ImperialCollegeLondon/QTIP/Images/Diagrams/MotorDriverSetupSchematic.png

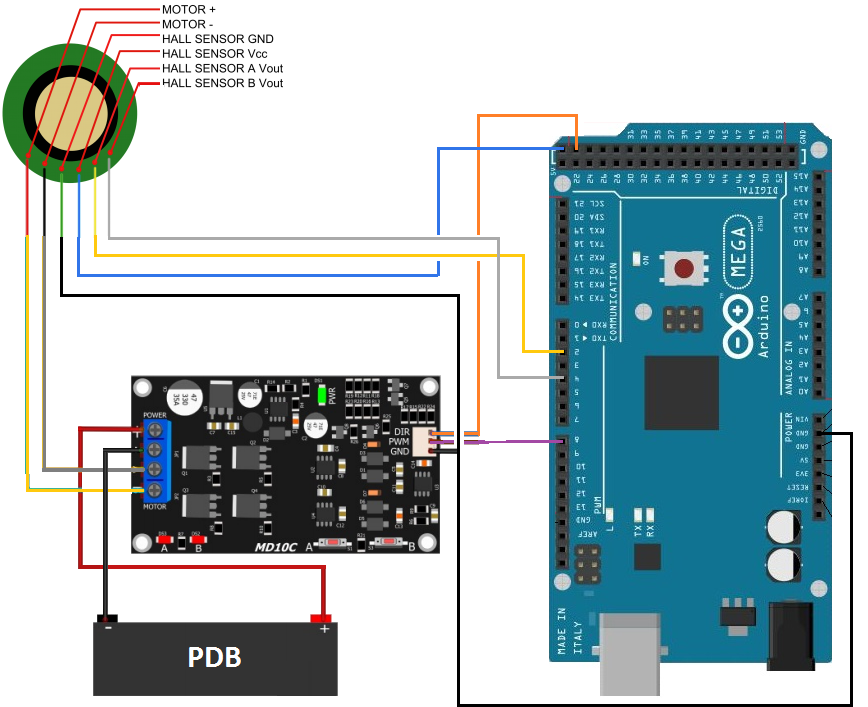
Images/Diagrams/MotorDriverSetupSchematic.png
