ImperialCollegeLondon/QTIP/Report/Figures/real.jpg

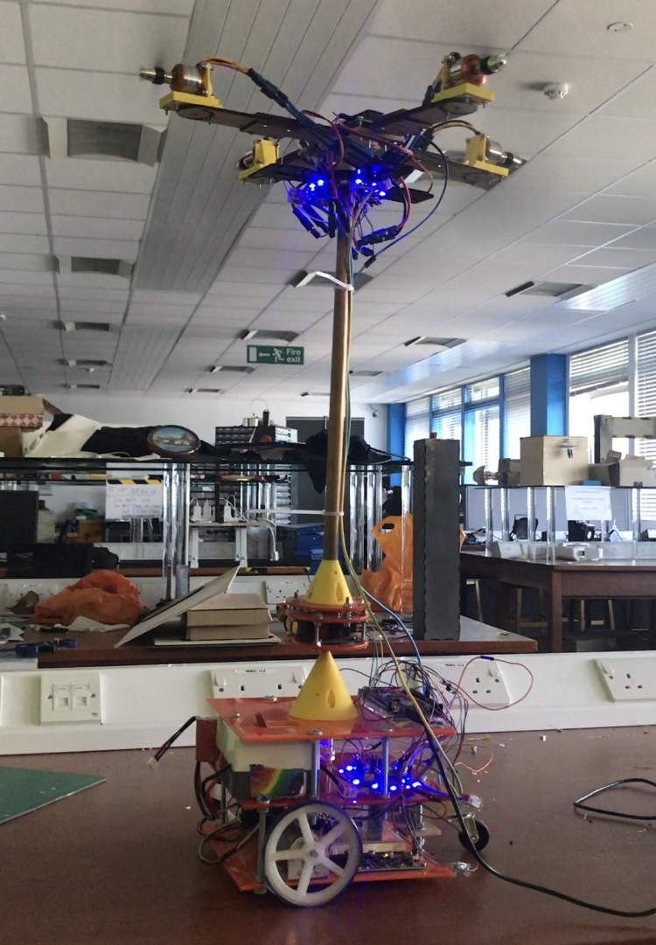
Report/Figures/real.jpg
