ImperialCollegeLondon/QTIP/README.md

# Quadrotor Topped Inverted Pendulum (QTIP)
