ImperialCollegeLondon/QTIP/Ruoxuan Jiang/Math Model (important).docx

1DOF Model:

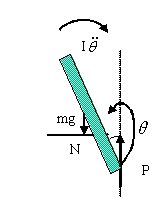
[picture p3: figure]

fθ’

mg

L

l

T2

T1

Torque equilibrium equation:

θ=((T2-T1)L+m_p glsinθ-θfl)/J

u=T1-T1

Setting , when ,,.

ϕ=(uL-m_p glϕ-ϕfl)/J

Linear Model:

[ϕϕ]=[0, 1(-m_p gl)/J, -(fl)/J][ϕϕ]+[0L/J]u

2DOF Model:

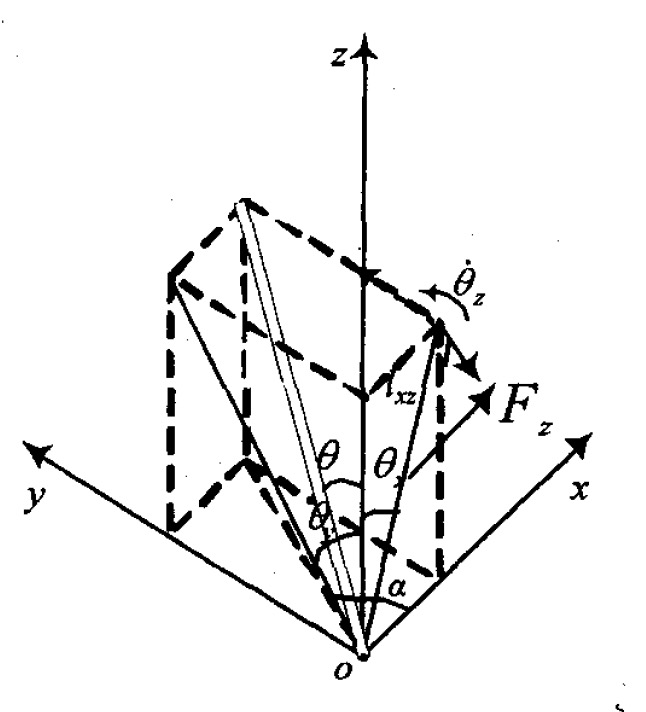
[picture p4: figure]

T2

T1

T4

fθx’

fθy’

mg

T3

By Lagrange's Equations:

L=T-V

d/(dt)((∂L)/(∂θ_x))-(∂L)/(∂θ_x)=F

T=1/2m_p gl^2 θ_x ^2

V=m_p glcosθ_x

L=T-V=1/2m_p l^2 θ_x ^2 -m_p glcosθ_x

d/(dt)((∂L)/(∂θ_x))-(∂L)/(∂θ_x)=m_p l^2 θ_x -m_p glsinθ_x

u1=T2-T1

m_p l^2 θ_x -m_p glsinθ_x =u1-θ_x f

Setting, when,,.

Setting θ_x =θ+π , when θ≪1 , cosθ_x =-1, sinθ_x =-θ .

θ=(-m_p glθ+u1-θf)/(m_p l^2)

Linear Model of system 1:

[θθ]=[0, 1-g/l, -f/(m_p l^2)][θθ]+[01/(m_p l^2)]u1

By symmetry:

Setting θ_y =ϕ+π , when ϕ≪1 , cosθ_y =-1, sinθ_y =-ϕ .

u2=T4-T3

ϕ=(-m_p glϕ+u2-ϕf)/(m_p l^2)

Linear Model of system 2:

[ϕϕ]=[0, 1-g/l, -f/(m_p l^2)][ϕϕ]+[01/(m_p l^2)]u2

3DOF Model:

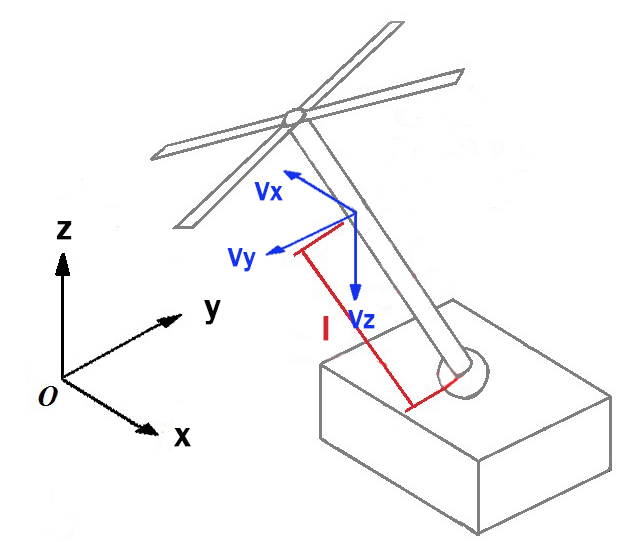
[picture p5: figure]

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
Setting the coordinate system of the pendulum around the point of O, which origin is the pivot connecting the pendulum and cart, is P=[x, y, z] .

z=√(l^2 -x^2 -y^2)

By Lagrange's Equations:

L=T-V

d/(dt)((∂L)/(∂θ_x))-(∂L)/(∂θ_x)=F

T=Tk+Tr

, which Tk is the kinetic energy, and Tr is the rotational energy.

Tr=1/2J_p Ω^T Ω

Ω=(P×P)/(L^2)=[yz-zyzx-xzxy-yx]/l^2

Tr=1/2J_p

Tk=1/2m_p v_p^2

v_p =√(v_x ^2 +v_y ^2 +v_z ^2)=√(x^2 +y^2 +z^2)

V=m_p gz

L=T-V=1/2m_p (x^2 +y^2 +z^2 )+1/2J_p Ω^T Ω-m_p gz

d/(dt)((∂L)/(∂x))-(∂L)/(∂x)=Tx

d/(dt)((∂L)/(∂y))-(∂L)/(∂y)=Ty

d/(dt)((∂L)/(∂ψ))-(∂L)/(∂ψ)=ft

u1=T2-T1-xf

u2=T4-T3-yf

Position Model:

R_x (ϕ)=[1, 0, 00, cos⁡(ϕ), sin⁡(ϕ)0, -sin⁡(ϕ), cos⁡(ϕ)]

R_y (θ)=[cos⁡(θ), 0, -sin⁡(θ)0, 1, 0sin⁡(θ), 0, cos⁡(θ)]

R_z (ψ)=[cos⁡(ψ), sin⁡(ψ), 0-sin⁡(ψ), cos⁡(ψ), 00, 0, 1]

The composite rotation matrix R depends on the order in which the roll, pitch and yaw rotations are applied as follows:

R_(zyx) =(R_x (ϕ)R_y (θ)R_z (ψ))^T

=[cos(ψ)cos(θ), -sin(ψ)cos(ϕ)+cos(ψ)sin(θ)sin(ϕ), sin(ψ)sin(ϕ)+cos(ψ)sin(θ)cos(ϕ)sin(ψ)cos(θ), cos(ψ)cos(ϕ)+sin(ψ)sin(θ)sin(ϕ), -cos(ψ)sin(ϕ)+sin(ψ)sin(θ)cos(ϕ)-sin(θ), cos(θ)sin(ϕ), cos(θ)cos(ϕ)]

[TxTyTz]=R_(zyx) [u1u20]=[u1cos(ψ)cos(θ)-u2sin(ψ)cos(ϕ)-sin(ϕ)sin(θ)cos(ψ)u2cos(ϕ)cos(ψ)+sin(ϕ)sin(ψ)sin(θ)+u1sin(ψ)cos(θ)u2sin(ϕ)cos(θ)-u1sin(θ)]

External moment vectors on each axis of the coordinate system:

∑ M=Iω+ω(Iω)

Angular velocity around each axis:

ω=[p, q, r]

Rotating inertia of three axis of this system:

I=diag[I_x , I_y , I_z ]

Setting as the

∑ M=[τ_p τ_q τ_r ]=[Lu1Lu2dFt]=[Lk_p (ω_2^2 -ω_1^2 )-xfLk_p (ω_4^2 -ω_3^2 )-yfdFt]

[pqr]=[(I_y -I_z)/(I_x)qr-Lk_p (ω_2^2 -ω_1^2 )-xf(I_y -I_x)/(I_y)pr-Lk_p (ω_4^2 -ω_3^2 )-yf(I_x -I_y)/(I_z)pq+dFt]

The relationship between Euler angular velocity and ω be expressed as:

[pqr]=[1, t, 00, cos⁡(ϕ), sin⁡(ϕ)0, -sin⁡(ϕ), cos⁡(ϕ)][pqr]

Table of Parameters:

Symbol | Definition | Symbol | Definition
ϕ | angle (rad) between pendulum and y axis upward | θ | angle (rad) between pendulum and y axis downward
D | Disturbance from the cart | m_p | Mass of pendulum
T_1 | Trust force from the right propeller | T_2 | Trust force from the left propeller
s | direction of the rotation | l | Distance from the origin to the mass center of the pendulum
g | Gravity | f | Friction disturbance (such as air)
J | Moment of inertial of the pendulum | L | length of the pendulum
l_i | Radius of propeller | C_D | Drag coefficient of propeller
C_(DF) | Zero lift drag | C_L | Lift coefficient of propeller
AR | Aspect Ratio | SE | Span efficiency factor
ω_i | Velocity of one propeller | F_D | Drag force of propeller
f_m | Resistance of propeller motor | K_V | Propeller motor back emf constant
K_Q | Propeller motor torque constant
V_(quad) | Voltage of propeller velocity | u_i | Command of Propeller
u_(max) | Max propeller command | d | Distance from the top center to the propeller center
ω | Angular velocity of pendulum about each axis | I | Rotating inertia of three axis of the system
