ImperialCollegeLondon/QTIP/Charlie Bell MSc/Presentation 10th July 18.pptx

## Quadrotor Top Inverted Pendulum (Q-TIP)

Controller design and synthesis

## Q-TIP: Purpose

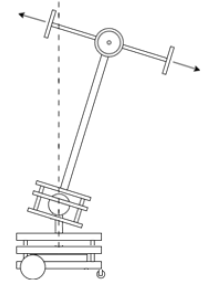
[picture p22: figure]

To showcase the capabilities of H_(∞) control on a highly nonlinear system.
Possibility of academic use for undergraduate students.
Demonstrate the importance of robust controllers in real systems.
The model is currently being verified using Simscape.

## H-infinity loop-shaping

Advantages:
Easily applicable to MIMO systems.
Similarly to LQR, the control problem is formulated as an optimisation problem.
Can be designed for the nominal model and applied to the real model.
Loop-shaping weights the plant transfer function in the frequency domain to minimise the sensitivity to noise, disturbances and plant-model mismatch.
Disadvantages:
Need a reasonably good model for the system to be controlled.
Controller is only optimal in relation to the selected cost function.

## H-infinity loop-shaping

Good tracking

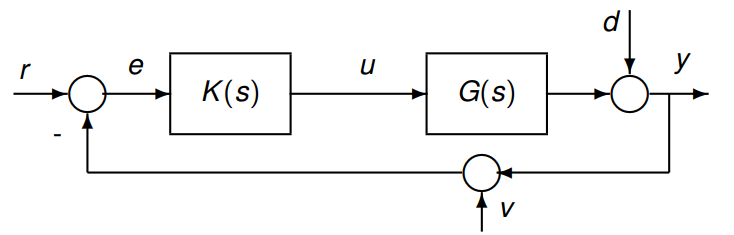
[picture p23: figure]

Noise attenuation,
Under multiplicative uncertainty

Robust under additive uncertainty

## MATLAB Robust Control Toolbox

augment/AUGW
hinfsyn

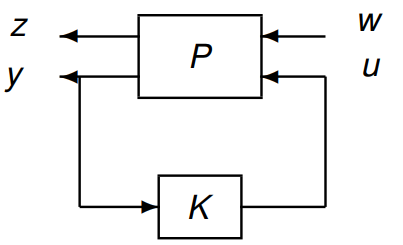
[picture p24: figure]
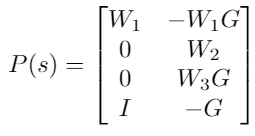
[picture p25: figure]

## Simulink Simscape Multibody

A powerful tool for simulating and visualising electromechanical systems.
Uses a reference frames and bodies along with physical bodies to build a model.
Can be linearised and extracted using linmod.

## Next steps and problems to be solved

- Testing of parts and subsystems.
- Estimation of parameters.
- Motor modelling.
- Measuring the buggy yaw
