ImperialCollegeLondon/QTIP/Ruoxuan Jiang/1DOF/1DOF model.docx

f

D

T3

T1

Torque equilibrium equation:

θ=((T3-T1)L+m_p gsinθ-θfl)/J

Setting , when ,,.

ϕ=(uL-m_p gϕ-ϕfl)/J

The mass of the pendulum: 0.853kg

The radius of the rod: 1.2cm, 0.012m

Then length of the pendulum: 0.52m

The density of the rod: 6939 kg/m^3

The mass of the rod: 0.095kg, length = 0.4m

m(rod)=(0.006^2 -0.005^2 )×π×0.36×6939=0.0863kg

m(small)=(0.006^2 -0.005^2 )×π×0.032×6939=0.00767kg

m(cone)=0.0184+0.00767=0.02607kg

m(cylinder)=0.1731kg

m(top)=0.853-0.095-0.02607-0.1731=0.5588kg

m(board)=(m(top))/2=0.2794kg

https://c-motion.com/v3dwiki/index.php/Segment_Inertia

Moment if inertia (cone):

x=r/R=0.015/0.038=0.3947

σ=1+x+x^2 =1+0.3947+0.3947^2 =1.5505

CG(cone)=((1+2x+3x^2 )h)/(4σ)=0.0138m

d(cone)=0.0138+0.04=0.0538m

δ=(3*m(cone))/(h*(r^2 +R*r+R^2 )π)=(3*0.02607)/(0.038*(0.015^2 +0.015*0.038+0.038^2 )*π)=297.78

a1=9/(20π), a2=((1+x+x^2 +x^3 +x^4 ))/σ=1.6363

b1=3/80, b2=((1+4x+10x^2 +4x^3 +x^4 ))/(σ^2)=1.8331

J(cone)=(a1*a2*m(cone)^2)/(δh)+b1b2m(cone)h^2 =1.4327e-05+2.5878e-06=0.000162kg*m^2

Moment if inertia (cylinder):

J(cylinder)=1/12m(cylinder)(3*r^2 +h^2 )=1/12*0.1731*(3*0.085^2 +0.04^2 )=0.000336kg*m^2

d(cone)=0.02m

Moment if inertia (rod):

J(rod)=1/12m(rod)(3*(r^2 +R^2 )+h^2 )=1/12*0.095*(3*(0.005^2 +0.006^2 )+0.4^2 )=0.0037kg*m^2

d(rod)=0.2+0.04+0.038=0.278m

Moment if inertia (top):

J_w (top)=1/12m(board)(d^2 +h^2 )=1/12*0.2794*(0.45^2 +??^2 )=0.0047kg*m^2

J_d (top)=1/12m(board)(w^2 +h^2 )=1/12*0.2794*(??^2 +0.003^2 )

J(top)=J_w (top)+J_d (top)

d(cone)=L-h=??m

Moment if inertia (pendulum):

J_p =∑ J+md^2 =J(cone)+J(cylinder)+J(rod)+J(top)+m(cone)d(cone)^2 +m(cylinder)d(cylinder)^2 + m(rod)d(crod)^2 +m(top)d(top)^2 =

Force of Propeller:

https://m-selig.ae.illinois.edu/props/propDB.html

Drag Force:

F_D =1/2ρv_(air) ^2 C_D S

Velocity of Propeller:

ω_i (rad/s)=(-1/(f_m K_V K_Q)+√(1/(f_m ^2 K_V ^2 K_Q ^2)-4F_d ((i_f)/(K_Q)-(V_(quad) u_i)/(f_m K_V u_(max)))))/(2F_d)

ω_i (rpm)=(ω_i ((rad)/s)*60)/(2π)

https://www.micromo.com/technical-library/dc-motor-tutorials/motor-calculations

i_f (Propeller motor friction current)=(P_(elec))/(V_(quad))

f_m (Resistance of propeller motor)=(V_(quad) -(ω_i)/(K_V))/(i_f)=(V_(quad) ^2 -(ω_i V_(quad))/(K_V))/(P_(elec))

https://en.wikipedia.org/wiki/Motor_constants#Motor_velocity_constant,_back_EMF_constant

K_V (Propeller motor speed constant)=(ω_i)/(V_(peak))=K_Q (Propeller motor torque constant)

Total thrust force of one propeller:

T_i =C_T ρω_i (rpm)^2 d_p ^2

Net Force:

u_1 =T_3 -T_1

u_2 =T_4 -T_2

Table of Parameters:

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
