ImperialCollegeLondon/QTIP/Modelling_and_Simulations/Controller designs/motor duty cycle vs servo.xlsx

Servo | Duty | Thrust | *thrust measured after battery was newly charged and at the centre of gravity
580 | 89.1 |  | *measured on rotor 1
590 | 89
600 | 87.5
650 | 85.7
700 | 81.3
750 | 78.1
800 | 75.6
900 | 69.3
1000 | 62.2 | 1.2
1100 | 56.3
1200 | 50 | 2.4
1300 | 43 | 3.2
1400 | 36.7 | 4
1500 | 30.7 | 4.8
1600 | 24.7 | 6
1700 | 17.6 | 6.4
1800 | 11.3 | 7.2
1900 | 5 | 7.6
2000 | 0 | 8.4
