ImperialCollegeLondon/QTIP/Fusion 360/Charlie  - September 2018/F/_distance sensing base Drawing.167a2c57-f452-4fe1-b7c8-098f2b4f054e.png

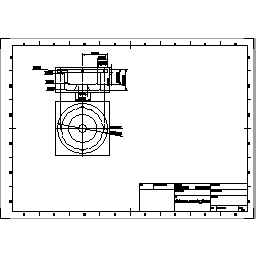
Fusion 360/Charlie - September 2018/F/_distance sensing base Drawing.167a2c57-f452-4fe1-b7c8-098f2b4f054e.png
