ImperialCollegeLondon/QTIP/Fusion 360/Charlie  - September 2018/F/_IR_Sensor_Base Drawing.a6438f55-29fa-4da2-a62e-f884ee1b2ce9.png

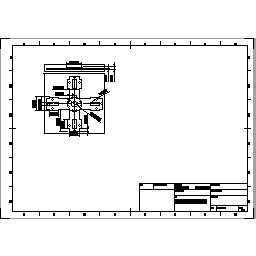
Fusion 360/Charlie - September 2018/F/_IR_Sensor_Base Drawing.a6438f55-29fa-4da2-a62e-f884ee1b2ce9.png
