ImperialCollegeLondon/QTIP/Fusion 360/Charlie  - September 2018/F/_motor_tips Drawing.4671a8ba-175e-485d-b543-e82fb5eeca1d.png

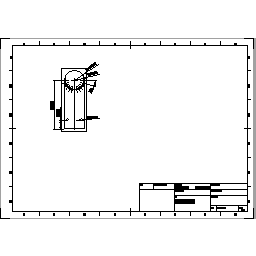
Fusion 360/Charlie - September 2018/F/_motor_tips Drawing.4671a8ba-175e-485d-b543-e82fb5eeca1d.png
