ImperialCollegeLondon/QTIP/Fusion 360/Charlie  - September 2018/F/_MPU6050_base Drawing.3a57cc98-4135-4280-b787-98bc39614aa1.png

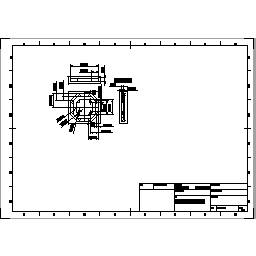
Fusion 360/Charlie - September 2018/F/_MPU6050_base Drawing.3a57cc98-4135-4280-b787-98bc39614aa1.png
