ImperialCollegeLondon/QTIP/Fusion 360/Charlie  - September 2018/F/_platesensor Drawing.8d1b1e26-c095-4f52-aa41-e85070347f9d.png

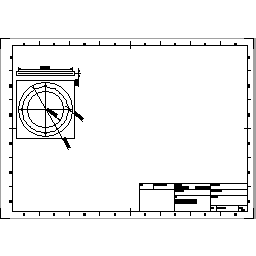
Fusion 360/Charlie - September 2018/F/_platesensor Drawing.8d1b1e26-c095-4f52-aa41-e85070347f9d.png
