ImperialCollegeLondon/QTIP/Images/Diagrams/App.png

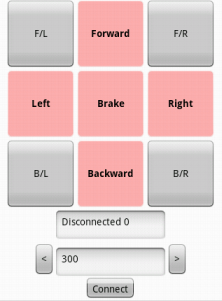
Images/Diagrams/App.png
