ImperialCollegeLondon/QTIP/Images/Diagrams/Directions.png

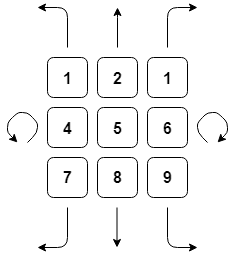
Images/Diagrams/Directions.png
