ImperialCollegeLondon/QTIP/Images/Diagrams/ESCSchem.png

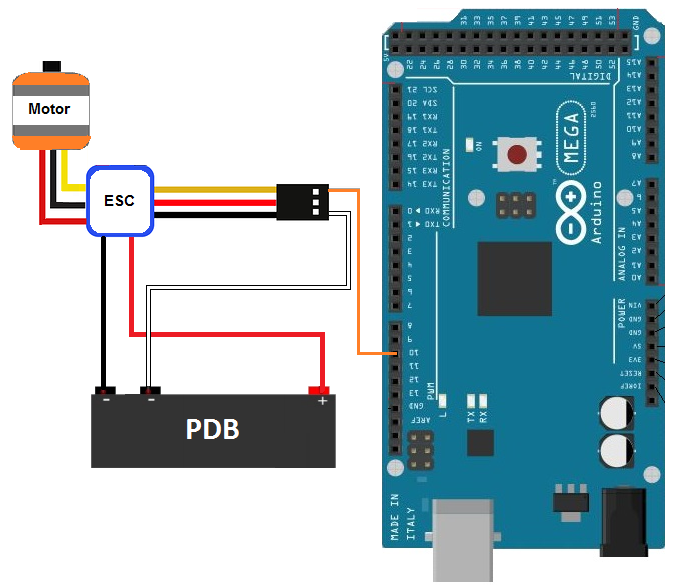
Images/Diagrams/ESCSchem.png
