ImperialCollegeLondon/QTIP/Images/Diagrams/FBD.png

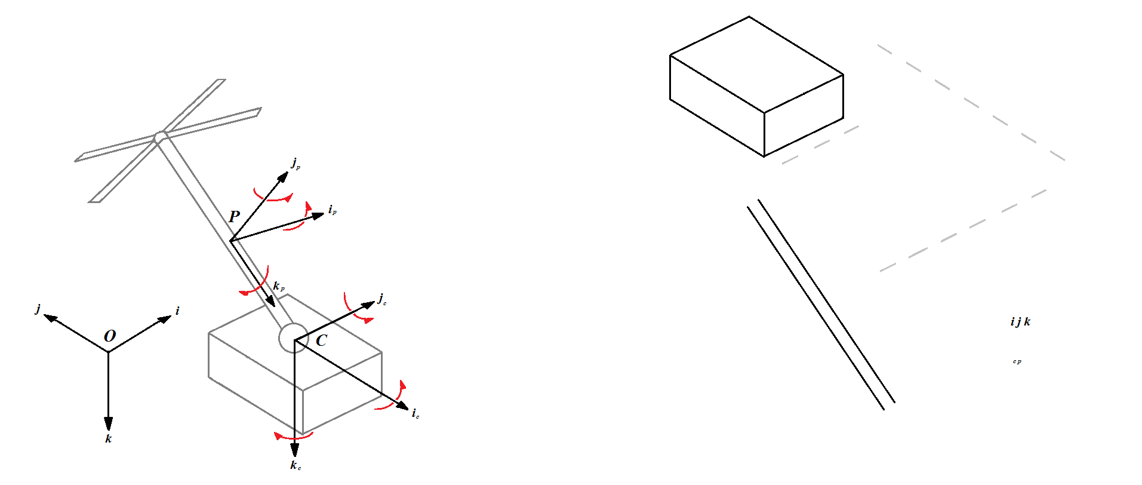
Images/Diagrams/FBD.png
