ImperialCollegeLondon/QTIP/Images/Diagrams/FBDNew.png

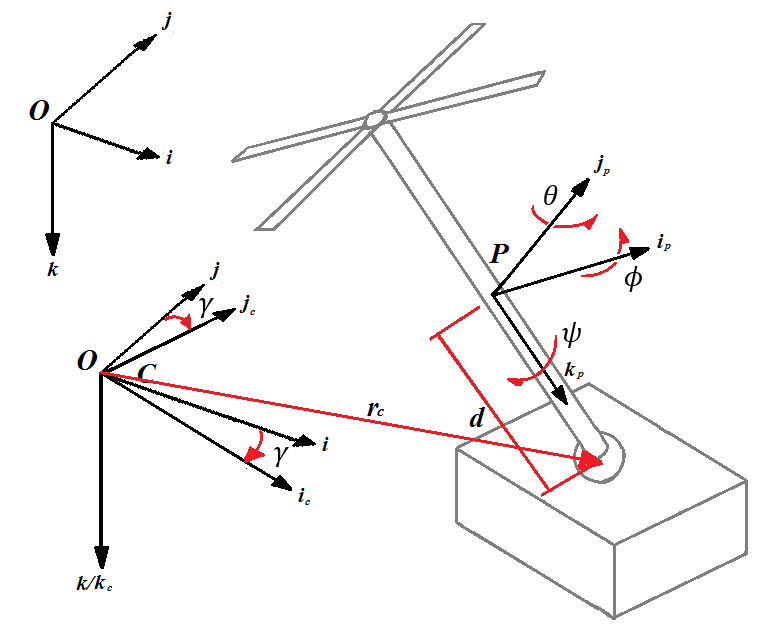
Images/Diagrams/FBDNew.png
