ImperialCollegeLondon/QTIP/Images/Diagrams/FrankiesSkinnyArms.png

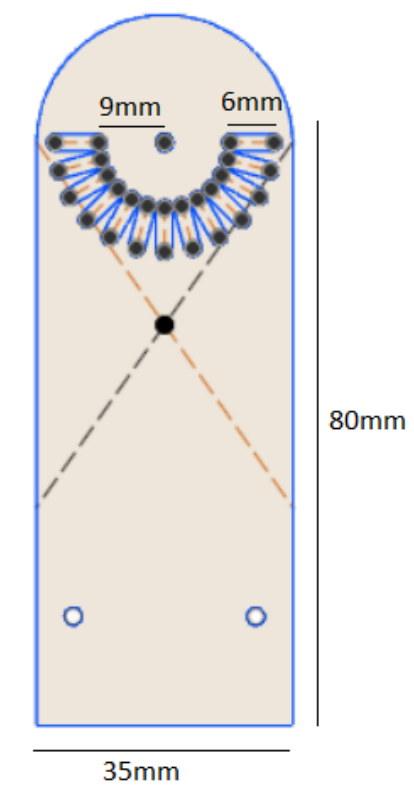
Images/Diagrams/FrankiesSkinnyArms.png
