ImperialCollegeLondon/QTIP/Images/Diagrams/HC05Scheme.png

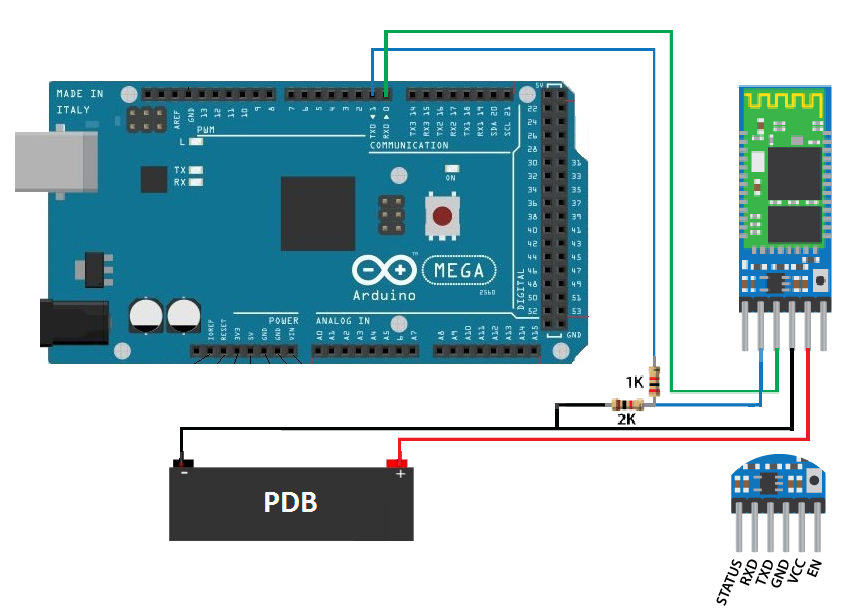
Images/Diagrams/HC05Scheme.png
