ImperialCollegeLondon/QTIP/Images/Diagrams/IRDistanceScheme.png

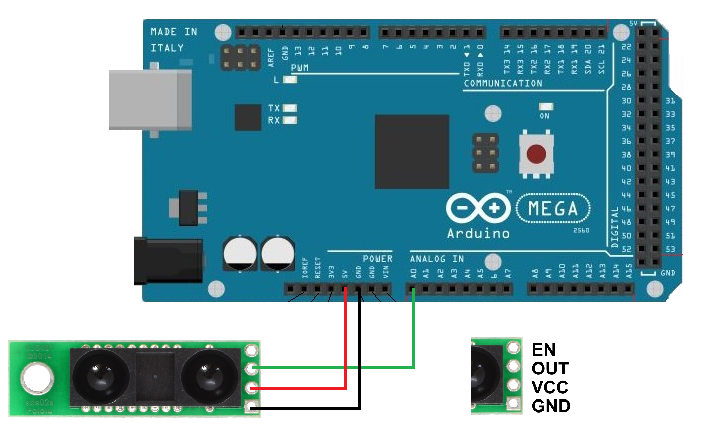
Images/Diagrams/IRDistanceScheme.png
