ImperialCollegeLondon/QTIP/Images/Diagrams/Mega2560.png

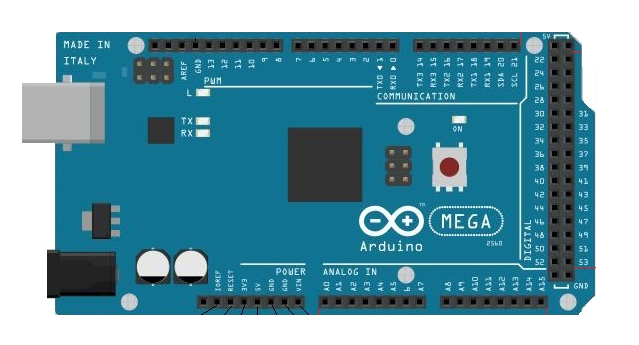
Images/Diagrams/Mega2560.png
