ImperialCollegeLondon/QTIP/Images/Diagrams/MPU6050Schem.png

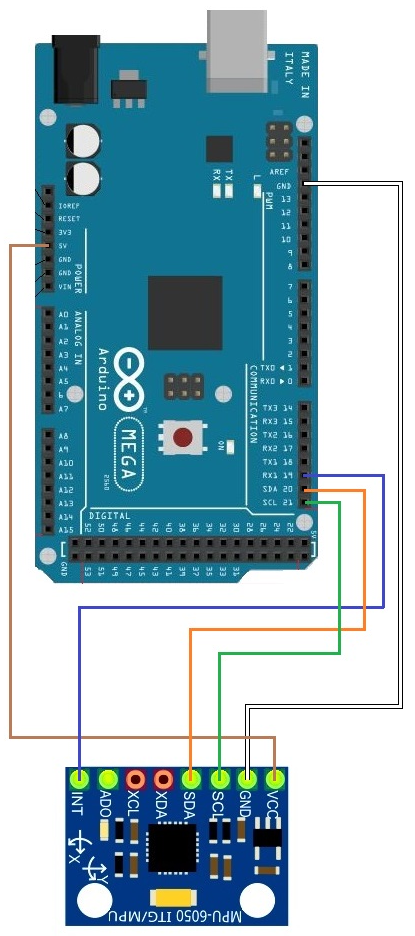
Images/Diagrams/MPU6050Schem.png
