ImperialCollegeLondon/QTIP/Images/Diagrams/QuadrotorFBD.png

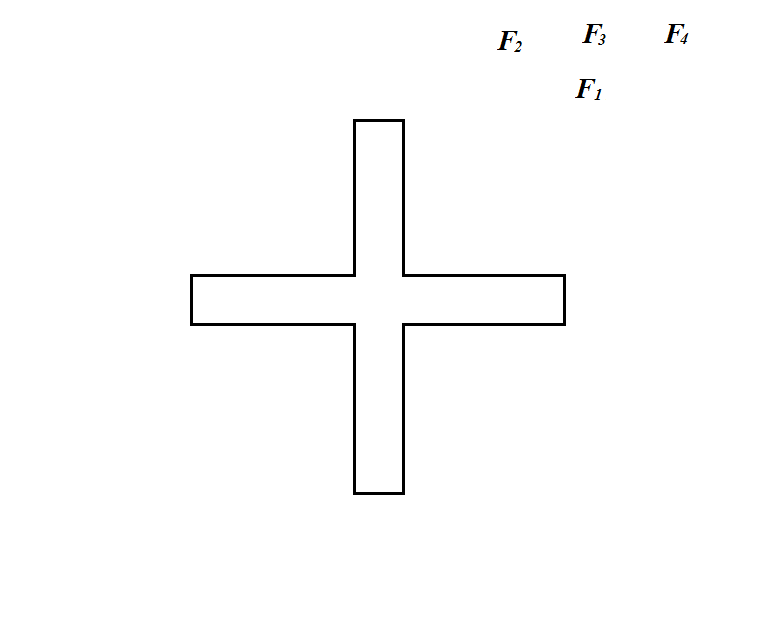
Images/Diagrams/QuadrotorFBD.png
