ImperialCollegeLondon/QTIP/Images/Diagrams/SoftwareDiagram.png

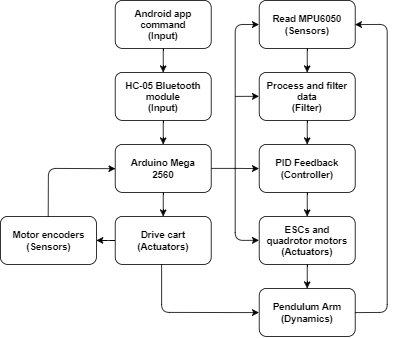
Images/Diagrams/SoftwareDiagram.png
