ImperialCollegeLondon/QTIP/Images/MCU mount/mount_brd.png

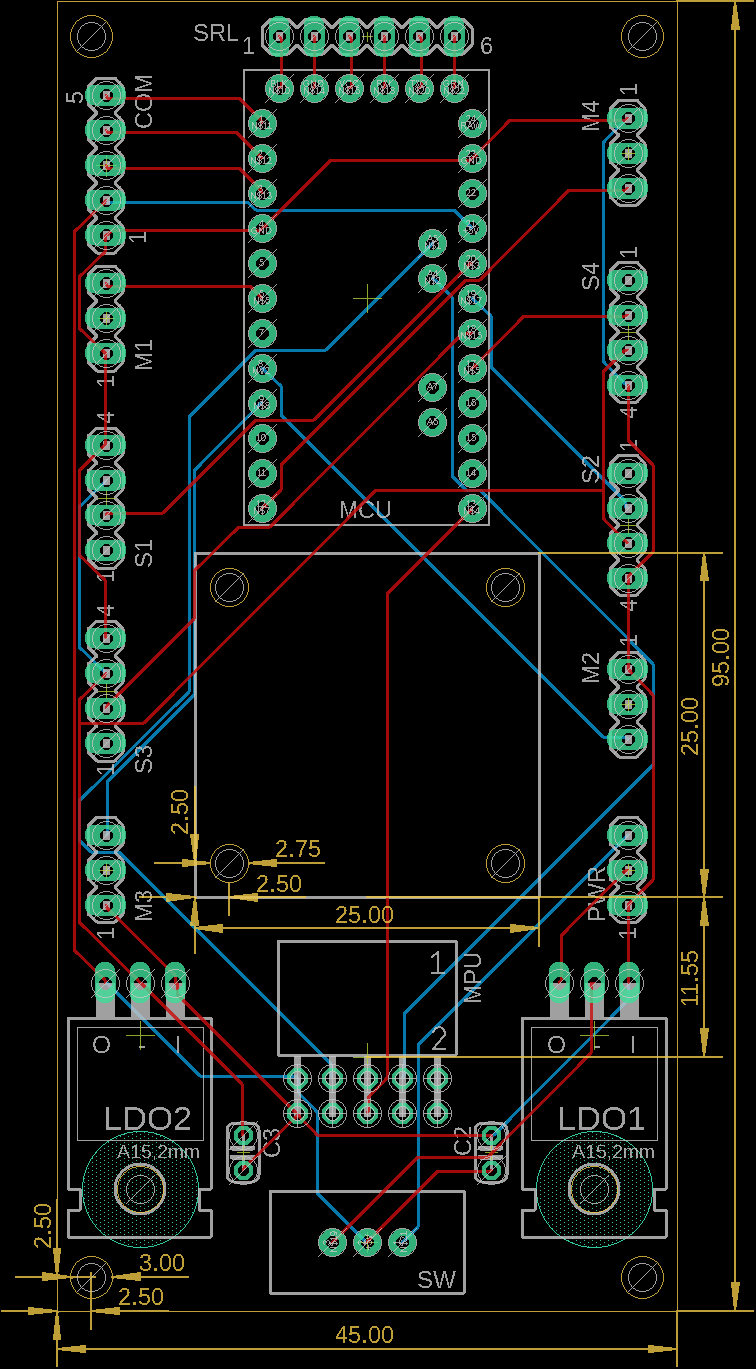
Images/MCU mount/mount_brd.png
