ImperialCollegeLondon/QTIP/Images/MCU mount/mount_sch.png

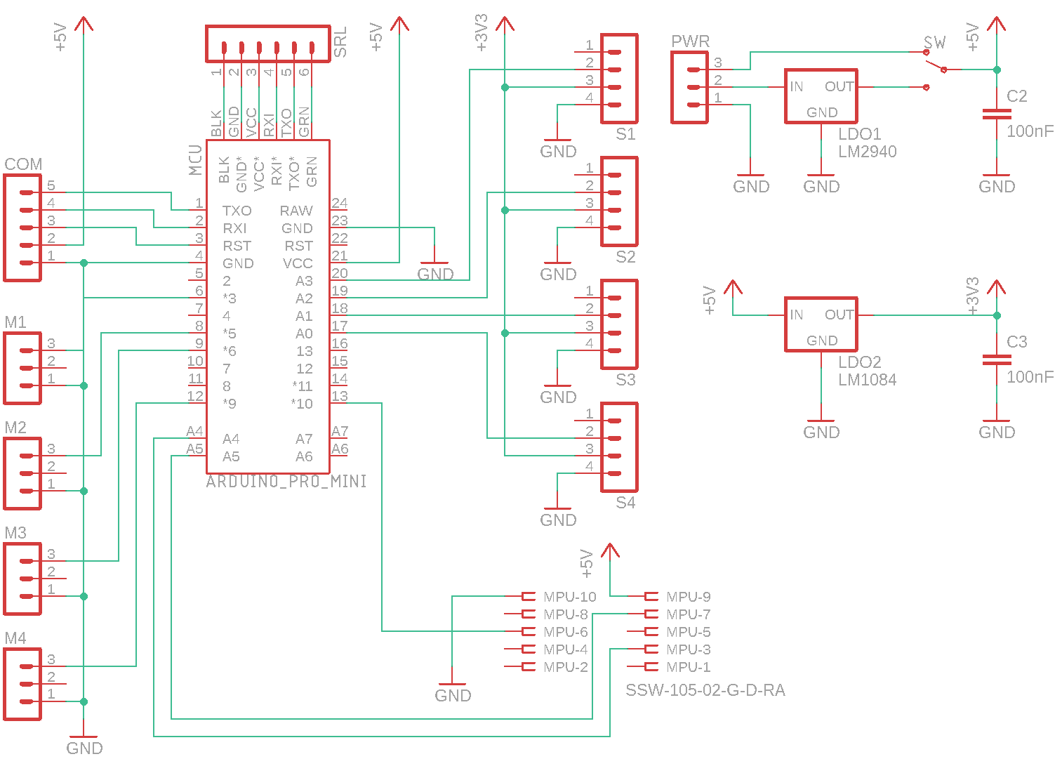
Images/MCU mount/mount_sch.png
