ImperialCollegeLondon/QTIP/Images/Photos/42234530_729942750677188_5877479439666774016_n.jpg

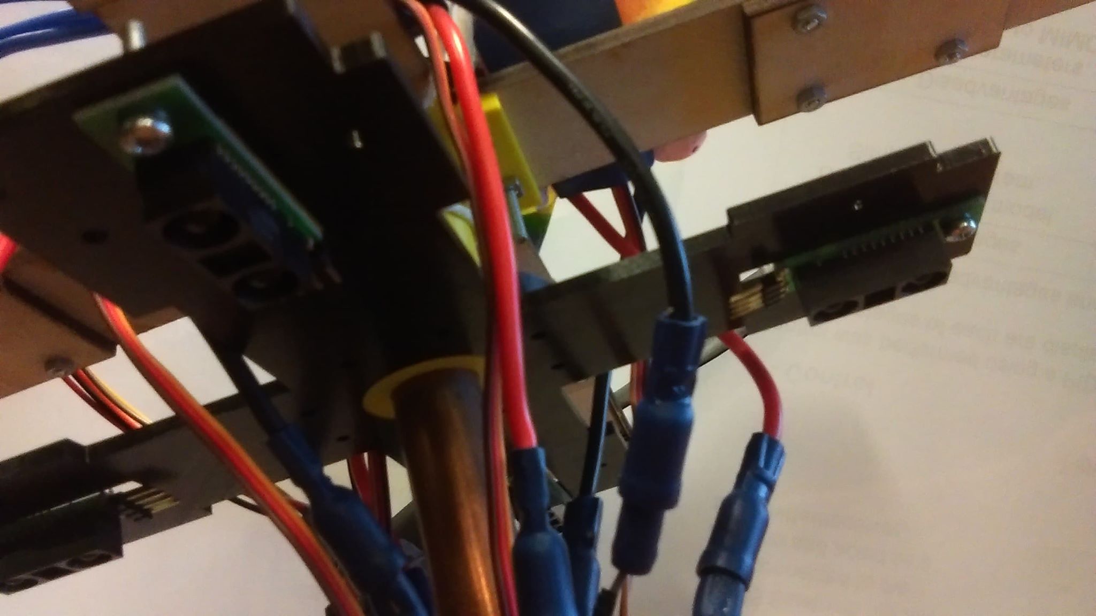
Images/Photos/42234530_729942750677188_5877479439666774016_n.jpg
