ImperialCollegeLondon/QTIP/Images/Photos/CartPhoto.png

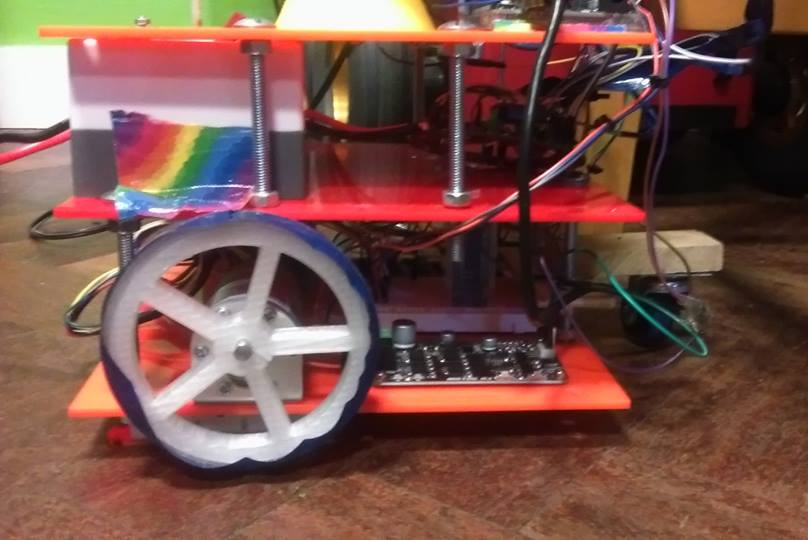
Images/Photos/CartPhoto.png
