ImperialCollegeLondon/QTIP/Images/Photos/CartSwitchPhoto.png

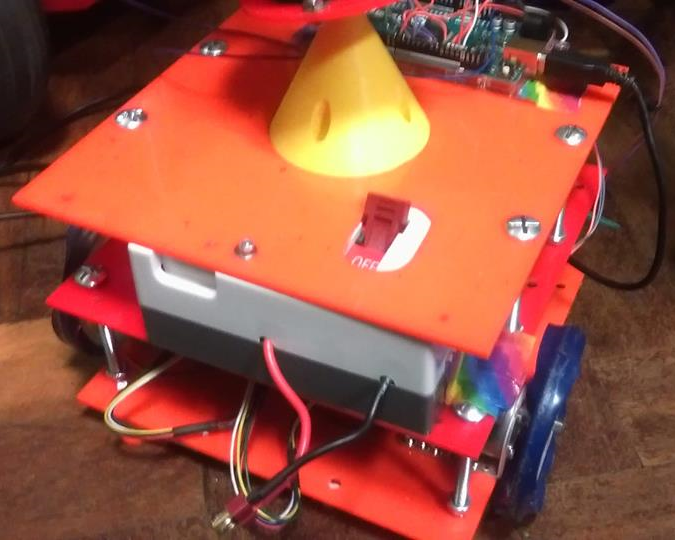
Images/Photos/CartSwitchPhoto.png
