ImperialCollegeLondon/QTIP/Images/Photos/CastorWheel.png

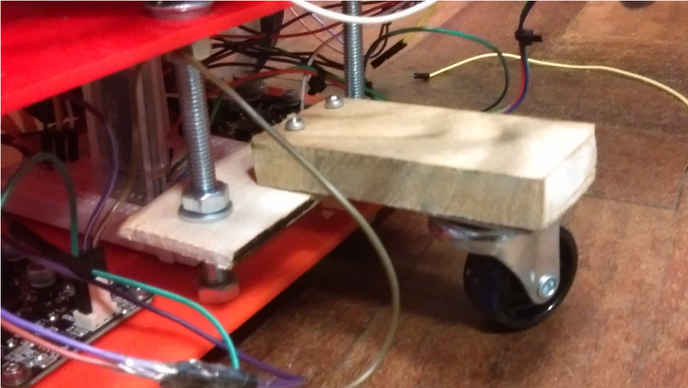
Images/Photos/CastorWheel.png
