ImperialCollegeLondon/QTIP/Images/Photos/Overview.png

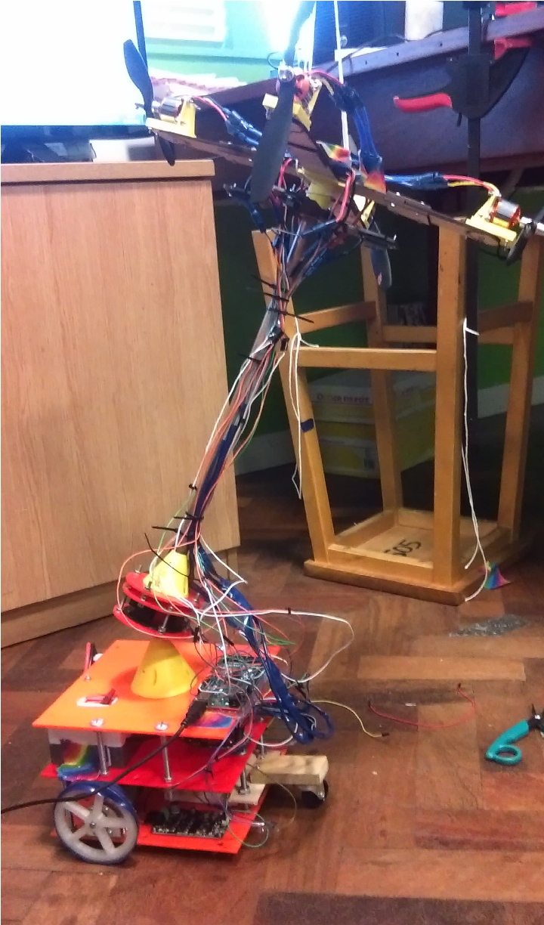
Images/Photos/Overview.png
