ImperialCollegeLondon/QTIP/Images/Photos/QuadrotorArmPhoto.png

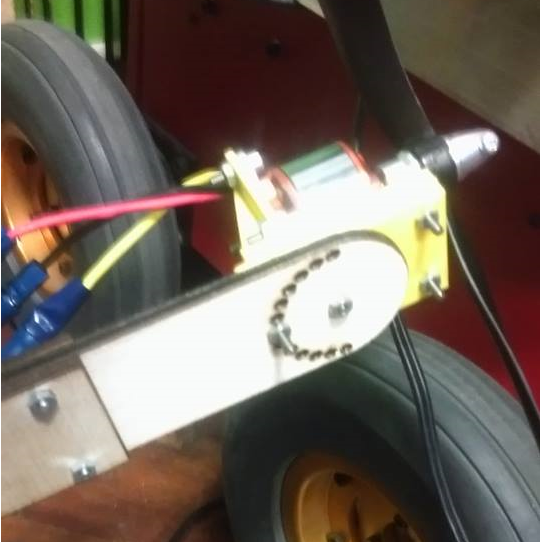
Images/Photos/QuadrotorArmPhoto.png
