ImperialCollegeLondon/QTIP/Images/Photos/QuadrotorPhoto.png

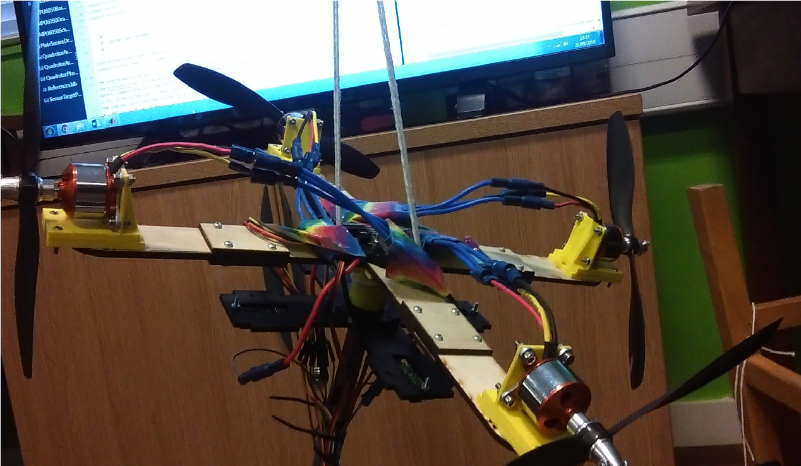
Images/Photos/QuadrotorPhoto.png
