ImperialCollegeLondon/QTIP/Images/Photos/SensorTargetPlatePhoto.png

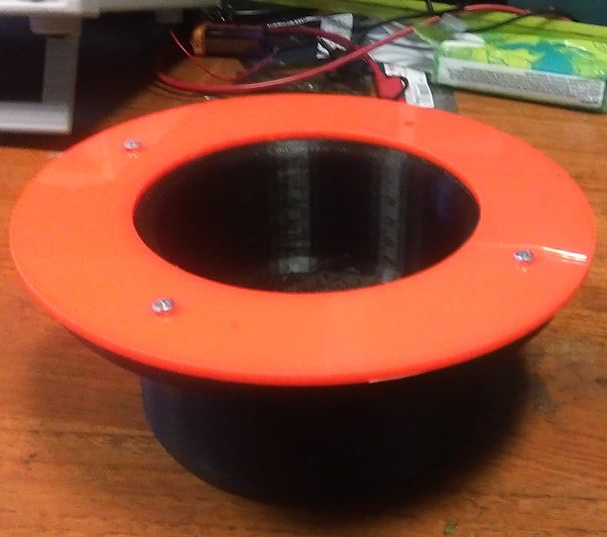
Images/Photos/SensorTargetPlatePhoto.png
