ImperialCollegeLondon/QTIP/Report/Figures/1dof1.jpg

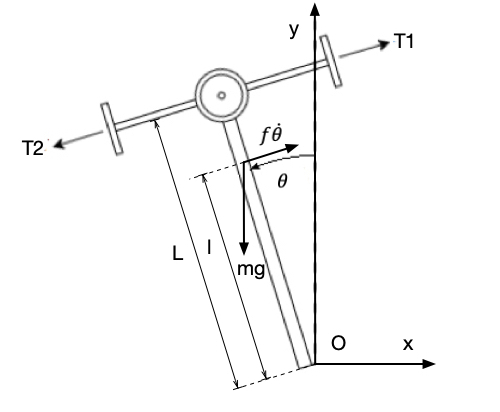
Report/Figures/1dof1.jpg
