ImperialCollegeLondon/QTIP/Report/Figures/1dof.graffle/image1.jpg

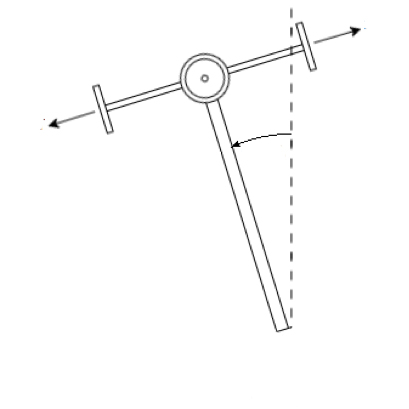
Report/Figures/1dof.graffle/image1.jpg
