ImperialCollegeLondon/QTIP/Report/Figures/2dof1.jpg

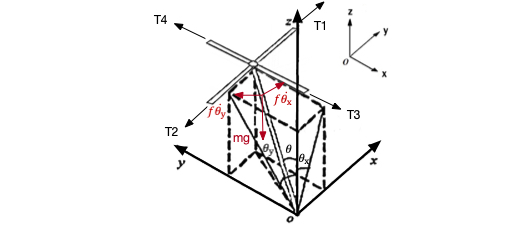
Report/Figures/2dof1.jpg
