ImperialCollegeLondon/QTIP/Report/Figures/2dof2.jpg

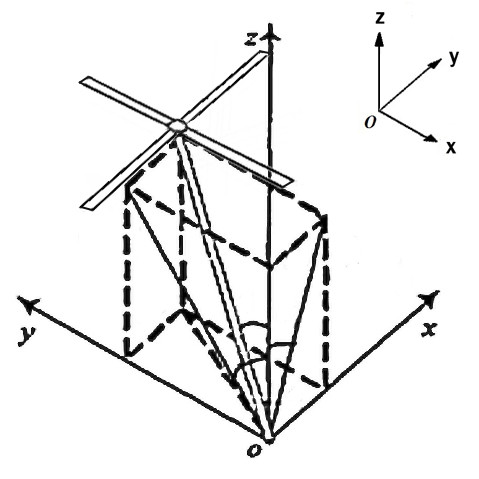
Report/Figures/2dof2.jpg
