ImperialCollegeLondon/QTIP/Report/Figures/2dof3.jpg

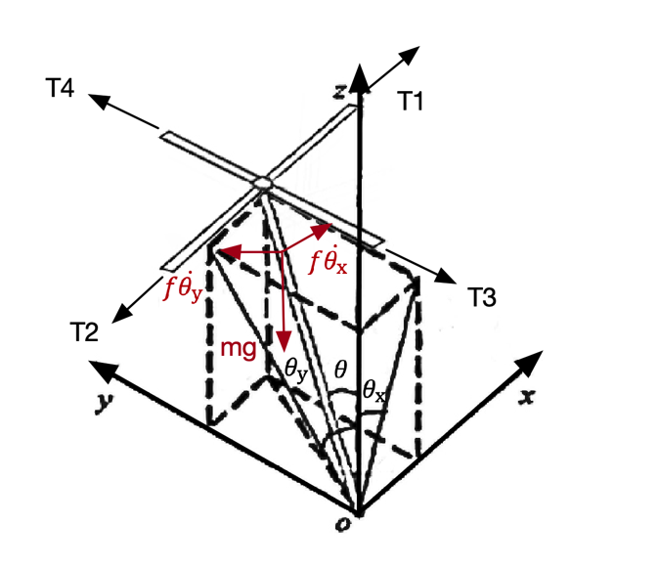
Report/Figures/2dof3.jpg
