ImperialCollegeLondon/QTIP/Report/Figures/3dof1.jpg

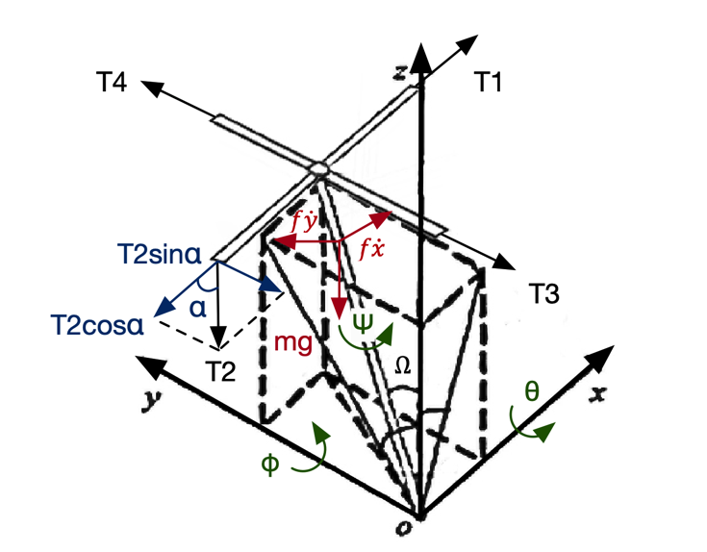
Report/Figures/3dof1.jpg
