ImperialCollegeLondon/QTIP/Report/Figures/3dof.jpg

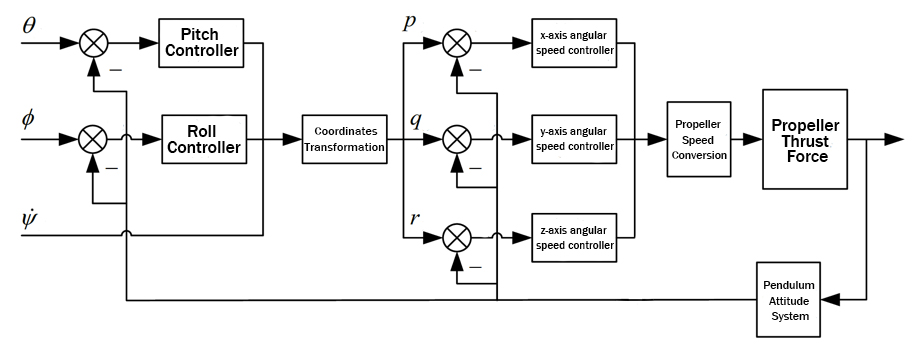
Report/Figures/3dof.jpg
