ImperialCollegeLondon/QTIP/Report/Figures/cone.jpg

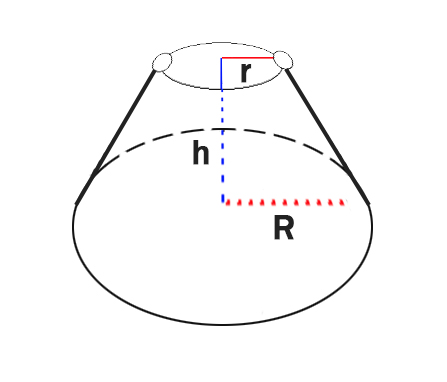
Report/Figures/cone.jpg
