ImperialCollegeLondon/QTIP/Report/Figures/pid_1dof_linear_u.png

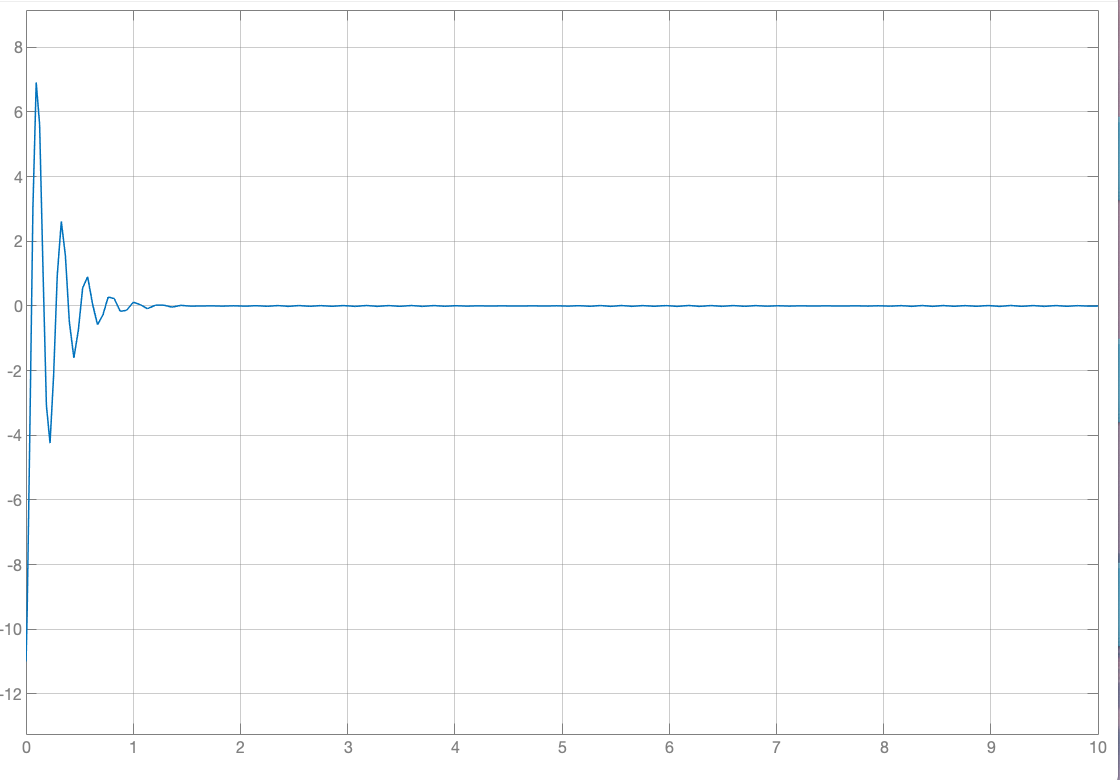
Report/Figures/pid_1dof_linear_u.png
