ImperialCollegeLondon/QTIP/Report/Figures/pid_1dof_nonlinear_u.png

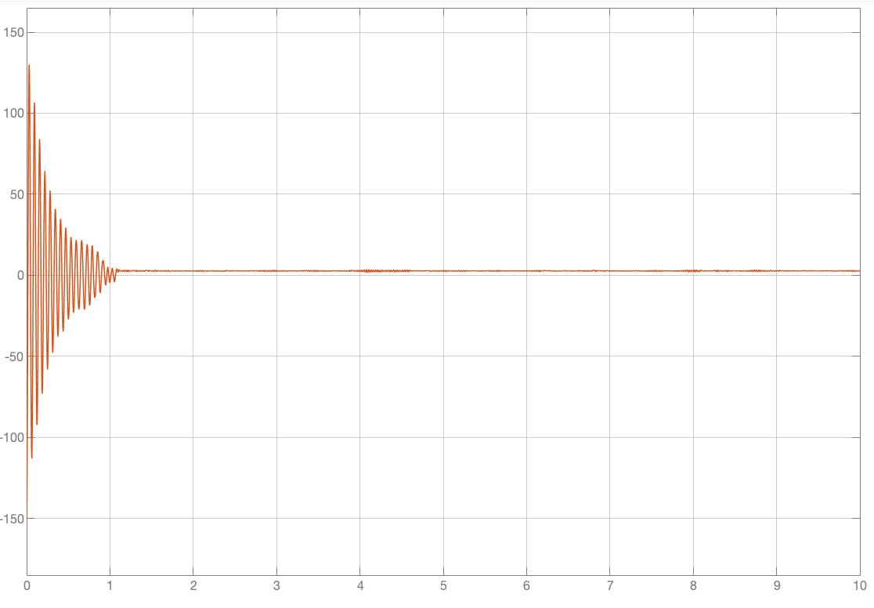
Report/Figures/pid_1dof_nonlinear_u.png
