ImperialCollegeLondon/QTIP/Report/Figures/quadrotor.jpg

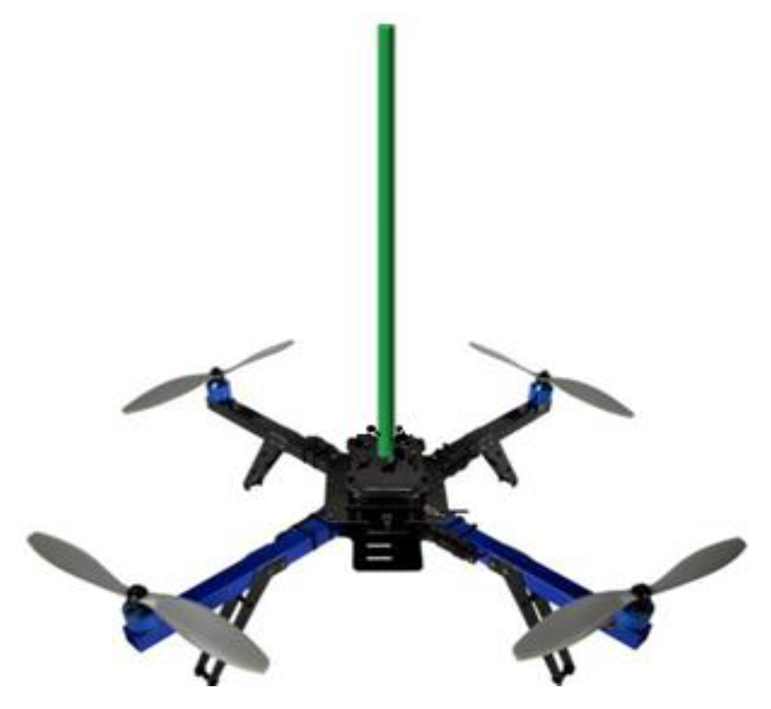
Report/Figures/quadrotor.jpg
