ImperialCollegeLondon/QTIP/Report/Figures/Snip20190828_3.png

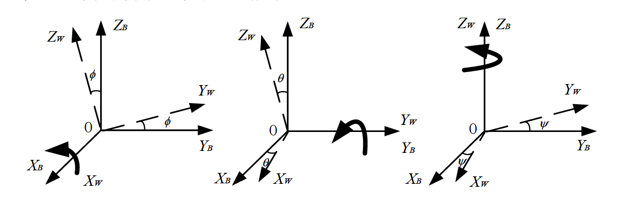
Report/Figures/Snip20190828_3.png
