ImperialCollegeLondon/QTIP/Report/Figures/Snip20190831_1.png

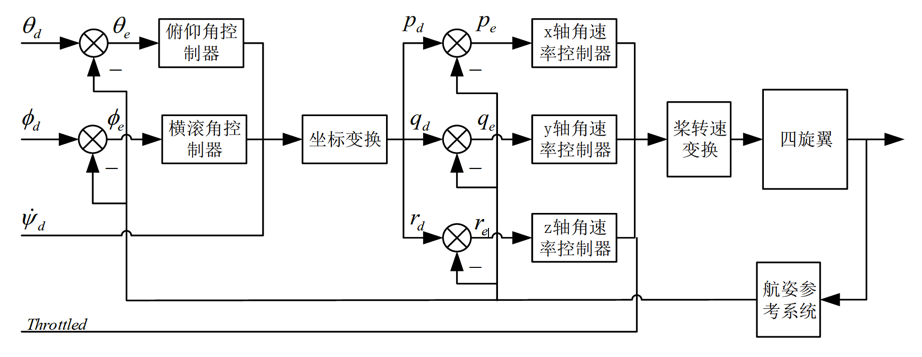
Report/Figures/Snip20190831_1.png
