ImperialCollegeLondon/QTIP/Report/Figures/stru2.graffle/image1.jpg

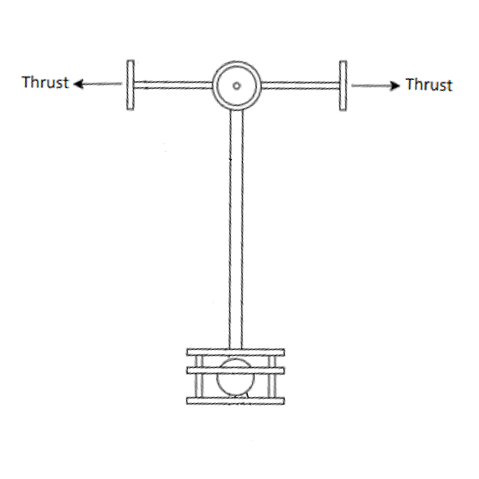
Report/Figures/stru2.graffle/image1.jpg
