ImperialCollegeLondon/QTIP/Report/Figures/stru2.jpg

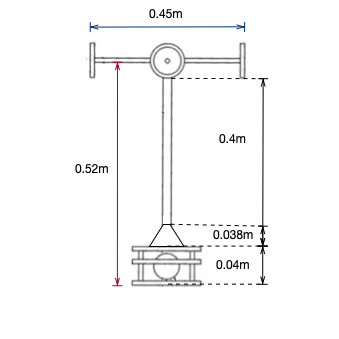
Report/Figures/stru2.jpg
