ImperialCollegeLondon/QTIP/Report/Figures/stru.jpg

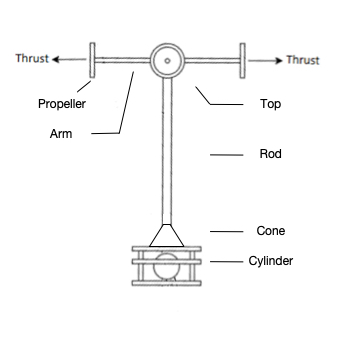
Report/Figures/stru.jpg
