ImperialCollegeLondon/QTIP/Report/Figures/thrust1.png

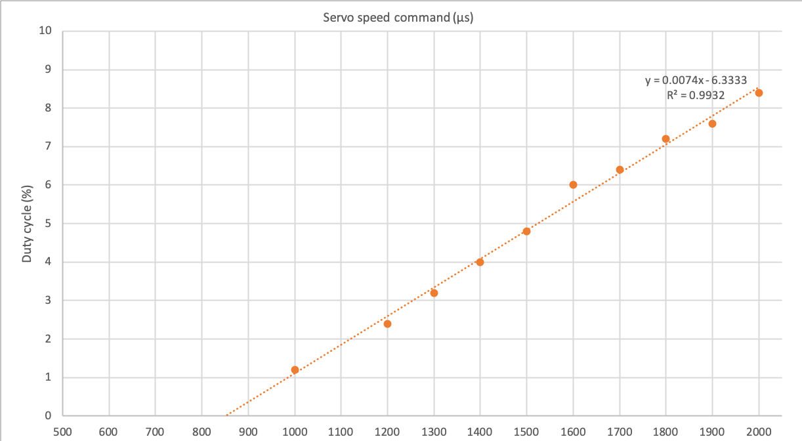
Report/Figures/thrust1.png
