ImperialCollegeLondon/QTIP/Report/Figures/WX20190827-165826@2x.png

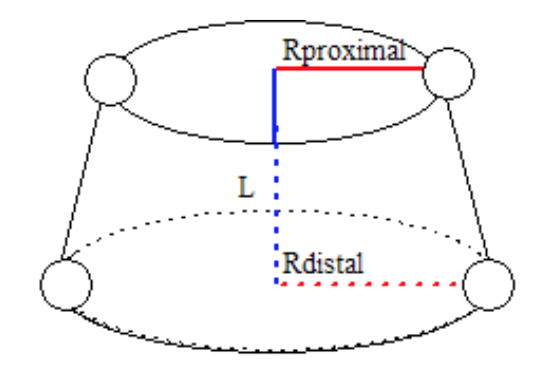
Report/Figures/WX20190827-165826@2x.png
