ImperialCollegeLondon/QTIP/(list of files, cad)

Other CAD files:
Fusion 360/Charlie - September 2018/D/38e7b07e-975d-44f5-a386-fe88bf291c5e.f2d
Fusion 360/Charlie - September 2018/D/65a1e838-8545-4bc1-8616-6649744bad84.f2d
Fusion 360/Charlie - September 2018/D/86ccd2f9-dcbd-4ddc-8e51-228e1d89fba8.f2d
Fusion 360/Charlie - September 2018/D/90396298-6234-49ed-ab1d-8a921f07f61a.f2d
Fusion 360/Charlie - September 2018/D/9a99e573-6a53-4ff8-bab7-74f84905e94e.f2d
Fusion 360/Charlie - September 2018/D/_0 dof.16f6d7bc-6823-48f0-af0c-f57e1ecf2a03.f3d
Fusion 360/Charlie - September 2018/D/_3dof ball joint limit.0818d55c-cfe8-4e3d-abe9-b31afa20470b.f3d
Fusion 360/Charlie - September 2018/D/_Bot_Buggy.67e68b21-76c9-4f74-ae45-ccdb9ae60464.f3d
Fusion 360/Charlie - September 2018/D/_FYP_Project.30689574-17b8-4f28-82bc-4a6d63cc6bb8.f3d
Fusion 360/Charlie - September 2018/D/_FYP_Project.e5b741b6-de03-4121-ac4c-455f43841e72.f3d
Fusion 360/Charlie - September 2018/D/_Mid_Buggy v1.d3fb6025-7d80-4e23-9cef-7aad12eae831.f3d
Fusion 360/Charlie - September 2018/D/_Top Motor Base.8a076834-c428-4551-9572-302d4211c724.f3d
Fusion 360/Charlie - September 2018/D/_Top_Buggy.84060d08-1e92-4c1e-bf3c-88f7ae413858.f3d
Fusion 360/Charlie - September 2018/D/_Wheel.690aa9d6-0443-4a5d-b359-7cdf34e08d0b.f3d
Fusion 360/Charlie - September 2018/D/_base_mount.aa962479-57d6-4ac7-87ad-e300ce6e1ebd.f3d
Fusion 360/Charlie - September 2018/D/_base_pendulum.549c1694-39ab-46a9-882e-bae70d5cbc87.f3d
Fusion 360/Charlie - September 2018/D/_bot bug 3d.2a260a3c-bb4b-4e1b-82d3-91d949180a34.f3d
Fusion 360/Charlie - September 2018/D/_bot_3D Joint.e1579b06-012f-4a59-916d-8962dbeb67df.f3d
Fusion 360/Charlie - September 2018/D/_bot_joint_plat.a9002315-c0e8-42a7-860a-0e363f9e170a.f3d
Fusion 360/Charlie - September 2018/D/_bot_joint_print.fe6107df-6920-4303-81a5-f8ed9eccbd60.f3d
Fusion 360/Charlie - September 2018/D/_camara top.273ecf29-dca3-4243-8d60-dc86f891365d.f3d
Fusion 360/Charlie - September 2018/D/_camaraside.b155b807-4a76-4751-a1d2-1a41744d9572.f3d
Fusion 360/Charlie - September 2018/D/_distance sensing base.b2dd820b-1519-46c9-ab9c-6e6810837444.f3d
Fusion 360/Charlie - September 2018/D/_double hinge.c73257d0-b62e-4581-b0a2-3ff71a05638e.f3d
Fusion 360/Charlie - September 2018/D/_full ball joint.4e98c3ed-7798-4968-9d94-7e01fe91851c.f3d
Fusion 360/Charlie - September 2018/D/_full structure.1b13a275-2b40-48d6-b8e3-0c061137abb3.f3d
Fusion 360/Charlie - September 2018/D/_joint_plat.13a4afc8-236e-41c7-890d-325f51f290e3.f3d
Fusion 360/Charlie - September 2018/D/_magnetic side.8d1368b1-dcc9-4457-ae46-fbf8c22e0692.f3d
Fusion 360/Charlie - September 2018/D/_motor base dimensions.a5abcd56-95d1-46e5-bf08-5968f5c64851.f3d
Fusion 360/Charlie - September 2018/D/_motor_base.ad4c3909-f81e-402d-8d75-62db66e27172.f3d
Fusion 360/Charlie - September 2018/D/_motor_tip_hold.2b4d487d-3483-482a-b781-73941d4ea9ba.f3d
Fusion 360/Charlie - September 2018/D/_motor_tip_hold_3D.4e5e734c-ea4f-4d34-8a0c-042d3958b99a.f3d
Fusion 360/Charlie - September 2018/D/_motor_tips_3D.b541b689-42d2-46c7-8ee2-95b9a4902e00.f3d
Fusion 360/Charlie - September 2018/D/_pend_connector.6113d6a6-ff1e-4e22-9ab8-4d74f2541897.f3d
Fusion 360/Charlie - September 2018/D/_pendulum.cdab3254-af17-42fb-b564-d7b699957a59.f3d
Fusion 360/Charlie - September 2018/D/_pendulum_3D.12d040be-d2c6-4b73-b759-7a2067bdbaf2.f3d
Fusion 360/Charlie - September 2018/D/_platesensor.ecb4e9c5-dacc-4da2-a371-615c9f19e751.f3d
Fusion 360/Charlie - September 2018/D/_rod_connector.48ad1f99-6f84-489f-a4ef-45fa8a27765f.f3d
Fusion 360/Charlie - September 2018/D/_sphere.aaea48cb-db7c-48fc-b7af-8c36bddd8de9.f3d
Fusion 360/Charlie - September 2018/D/_top joint with sphere and pin.c2aade80-2db6-4851-90f9-92e80436383d.f3d
Fusion 360/Charlie - September 2018/D/_top_3D Joint.6bec6398-35c7-4d56-b3d9-7a9582a43d99.f3d
Fusion 360/Charlie - September 2018/D/_top_3D Joint.c7dbc639-92e2-42d0-a810-be37d3c962a2.f3d
Fusion 360/Charlie - September 2018/D/_top_joint_plat.c9467187-65b0-4059-81ec-43d11235db25.f3d
Fusion 360/Charlie - September 2018/D/_top_joint_print.99a3b0ba-869c-4ecd-9347-2f76327057b6.f3d
Fusion 360/Charlie - September 2018/D/_yaw_control.2c9c1f70-ecd5-4a5c-8550-4e08fa1fc980.f3d
Fusion 360/Charlie - September 2018/D/_yawlimit.5599f793-35cf-4079-a206-6b33523ced57.f3d
Fusion 360/Charlie - September 2018/D/f1c0c4da-e56a-4784-b9db-c6fed15633ae.f2d
Fusion 360/Charlie - September 2018/F/_0 dof.16f6d7bc-6823-48f0-af0c-f57e1ecf2a03.f3d
Fusion 360/Charlie - September 2018/F/_3dof ball joint limit.0818d55c-cfe8-4e3d-abe9-b31afa20470b.f3d
Fusion 360/Charlie - September 2018/F/_Bot_Buggy.67e68b21-76c9-4f74-ae45-ccdb9ae60464.f3d
Fusion 360/Charlie - September 2018/F/_FYP_Project.30689574-17b8-4f28-82bc-4a6d63cc6bb8.f3d
Fusion 360/Charlie - September 2018/F/_FYP_Project.e5b741b6-de03-4121-ac4c-455f43841e72.f3d
Fusion 360/Charlie - September 2018/F/_IR_Sensor_Base Drawing.a6438f55-29fa-4da2-a62e-f884ee1b2ce9.f2d
Fusion 360/Charlie - September 2018/F/_MPU6050_base Drawing.3a57cc98-4135-4280-b787-98bc39614aa1.f2d
Fusion 360/Charlie - September 2018/F/_Mid_Buggy v1.d3fb6025-7d80-4e23-9cef-7aad12eae831.f3d
Fusion 360/Charlie - September 2018/F/_Top Motor Base.8a076834-c428-4551-9572-302d4211c724.f3d
Fusion 360/Charlie - September 2018/F/_Top_Buggy.84060d08-1e92-4c1e-bf3c-88f7ae413858.f3d
Fusion 360/Charlie - September 2018/F/_Wheel.690aa9d6-0443-4a5d-b359-7cdf34e08d0b.f3d
Fusion 360/Charlie - September 2018/F/_base_mount.aa962479-57d6-4ac7-87ad-e300ce6e1ebd.f3d
Fusion 360/Charlie - September 2018/F/_base_pendulum.549c1694-39ab-46a9-882e-bae70d5cbc87.f3d
Fusion 360/Charlie - September 2018/F/_bot bug 3d.2a260a3c-bb4b-4e1b-82d3-91d949180a34.f3d
Fusion 360/Charlie - September 2018/F/_bot_3D Joint.e1579b06-012f-4a59-916d-8962dbeb67df.f3d
Fusion 360/Charlie - September 2018/F/_bot_joint_plat.a9002315-c0e8-42a7-860a-0e363f9e170a.f3d
Fusion 360/Charlie - September 2018/F/_bot_joint_print.fe6107df-6920-4303-81a5-f8ed9eccbd60.f3d
Fusion 360/Charlie - September 2018/F/_camara top.273ecf29-dca3-4243-8d60-dc86f891365d.f3d
Fusion 360/Charlie - September 2018/F/_camaraside.b155b807-4a76-4751-a1d2-1a41744d9572.f3d
Fusion 360/Charlie - September 2018/F/_distance sensing base Drawing.167a2c57-f452-4fe1-b7c8-098f2b4f054e.f2d
Fusion 360/Charlie - September 2018/F/_distance sensing base.b2dd820b-1519-46c9-ab9c-6e6810837444.f3d
Fusion 360/Charlie - September 2018/F/_double hinge.c73257d0-b62e-4581-b0a2-3ff71a05638e.f3d
Fusion 360/Charlie - September 2018/F/_full ball joint.4e98c3ed-7798-4968-9d94-7e01fe91851c.f3d
Fusion 360/Charlie - September 2018/F/_full structure.1b13a275-2b40-48d6-b8e3-0c061137abb3.f3d
Fusion 360/Charlie - September 2018/F/_joint_plat.13a4afc8-236e-41c7-890d-325f51f290e3.f3d
Fusion 360/Charlie - September 2018/F/_magnetic side.8d1368b1-dcc9-4457-ae46-fbf8c22e0692.f3d
Fusion 360/Charlie - September 2018/F/_motor base dimensions.a5abcd56-95d1-46e5-bf08-5968f5c64851.f3d
Fusion 360/Charlie - September 2018/F/_motor_base.ad4c3909-f81e-402d-8d75-62db66e27172.f3d
Fusion 360/Charlie - September 2018/F/_motor_tip_hold.2b4d487d-3483-482a-b781-73941d4ea9ba.f3d
Fusion 360/Charlie - September 2018/F/_motor_tip_hold_3D.4e5e734c-ea4f-4d34-8a0c-042d3958b99a.f3d
Fusion 360/Charlie - September 2018/F/_motor_tips Drawing.4671a8ba-175e-485d-b543-e82fb5eeca1d.f2d
Fusion 360/Charlie - September 2018/F/_motor_tips_3D.b541b689-42d2-46c7-8ee2-95b9a4902e00.f3d
Fusion 360/Charlie - September 2018/F/_pend_connector.6113d6a6-ff1e-4e22-9ab8-4d74f2541897.f3d
Fusion 360/Charlie - September 2018/F/_pendulum.cdab3254-af17-42fb-b564-d7b699957a59.f3d
Fusion 360/Charlie - September 2018/F/_pendulum_3D.12d040be-d2c6-4b73-b759-7a2067bdbaf2.f3d
Fusion 360/Charlie - September 2018/F/_platesensor Drawing.7e41d2c2-2f0d-4407-9537-a03fe6288127.f2d
Fusion 360/Charlie - September 2018/F/_platesensor Drawing.8d1b1e26-c095-4f52-aa41-e85070347f9d.f2d
Fusion 360/Charlie - September 2018/F/_platesensor.ecb4e9c5-dacc-4da2-a371-615c9f19e751.f3d
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
