ImperialCollegeLondon/QTIP/Plot Results/CharlieBellResults.xlsx

Sheet: Sheet2
2 | 0 | 0 | 0 | 2 | 0 | 0 | 0 | 2 | -0.14 | 0.08 | 0.1 | 2 | -0.77 | 0.03 | 0.03 | 2 | 0 | 0 | 0
11 | 0.14 | 0.02 | -0.03 | 5 | 0 | 0 | 0 | 5 | -0.14 | 0.08 | 0.1 | 12 | 0.87 | 0.28 | -0.26 | 4 | 0 | 0 | 0
20 | 0.14 | 0.02 | -0.03 | 14 | 0 | 0.04 | 0.32 | 15 | -0.01 | 0.31 | 0.01 | 16 | 0.87 | 0.28 | -0.26 | 13 | -0.08 | 0.03 | 0
24 | 0.14 | 0.02 | -0.03 | 23 | 0 | 0.04 | 0.32 | 18 | -0.01 | 0.31 | 0.01 | 25 | 0.87 | 0.28 | -0.26 | 24 | -0.08 | 0.03 | 0
33 | 0.14 | 0.02 | -0.03 | 26 | 0 | 0.04 | 0.32 | 28 | -0.01 | 0.31 | 0.01 | 34 | 0.87 | 0.28 | -0.26 | 33 | -0.08 | 0.03 | 0
43 | 0.14 | 0.02 | -0.03 | 36 | 0 | 0.04 | 0.32 | 37 | -0.01 | 0.31 | 0.01 | 43 | 0.87 | 0.28 | -0.26 | 36 | -0.08 | 0.03 | 0
52 | 0.14 | 0.02 | -0.03 | 45 | 0 | 0.04 | 0.32 | 46 | -0.01 | 0.31 | 0.01 | 53 | 0.87 | 0.28 | -0.26 | 45 | -0.08 | 0.03 | 0
61 | 0.14 | 0.02 | -0.03 | 54 | 0 | 0.04 | 0.32 | 56 | -0.01 | 0.31 | 0.01 | 62 | 0.87 | 0.28 | -0.26 | 54 | -0.08 | 0.03 | 0
71 | 0.14 | 0.02 | -0.03 | 64 | 0 | 0.04 | 0.32 | 65 | -0.01 | 0.31 | 0.01 | 66 | 0.87 | 0.28 | -0.26 | 63 | -0.08 | 0.03 | 0
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
