ImperialCollegeLondon/QTIP/Test Data/Loop duration/190517-04.xlsx

10 | mean | 10.01
10 | st.dev | 0.5922642504
9
11
10
10
10 |  |  | logged after 1 second
11
9
10
9
10
11
10
10
10
10
10
10
10
11
9
10
10
9
11
10
10
10
10
10
10
10
11
10
9
10
10
10
10
10
10
11
9
10
10
10
10
10
10
11
10
9
10
11
10
10
9
10
11
9
10
10
11
10
9
10
11
10
10
9
11
10
10
9
10
11
10
10
9
11
10
9
10
11
10
10
9
10
11
10
10
10
10
10
10
9
11
10
10
10
10
10
10
10
9
11
10
10
10
10
10
10
10
11
10
9
10
11
9
10
10
10
11
9
10
10
10
10
10
10
11
10
9
10
11
9
10
10
10
11
9
10
10
11
10
10
9
11
10
9
10
11
10
10
9
10
11
9
10
10
11
10
10
9
11
10
10
9
11
10
10
10
9
11
10
10
10
10
10
10
9
11
10
10
10
11
9
10
10
9
11
10
10
10
10
10
10
10
11
9
10
10
10
10
10
10
10
11
10
9
10
10
10
10
10
11
10
9
10
10
11
10
9
10
11
9
10
10
11
10
9
10
11
10
10
9
10
11
9
10
10
11
10
10
9
11
10
10
10
10
10
10
9
10
11
10
10
9
11
10
9
10
11
10
10
10
9
11
10
10
10
10
10
10
9
11
10
10
10
10
10
10
10
11
10
9
10
10
10
10
10
10
11
9
10
10
10
10
10
10
10
11
9
10
10
11
10
9
10
11
9
10
10
11
10
9
10
10
11
10
10
9
11
9
10
10
11
10
10
9
11
10
10
9
10
11
10
9
10
11
10
10
10
10
10
9
10
11
10
10
10
9
11
10
10
10
10
10
10
9
11
10
10
10
11
9
10
10
10
10
10
10
10
10
10
10
10
11
9
10
10
9
11
10
10
10
11
9
10
10
11
10
9
10
11
9
10
10
10
