ImperialCollegeLondon/QTIP/Images/Diagrams/IR_Sensor_Base Drawing v4.pdf

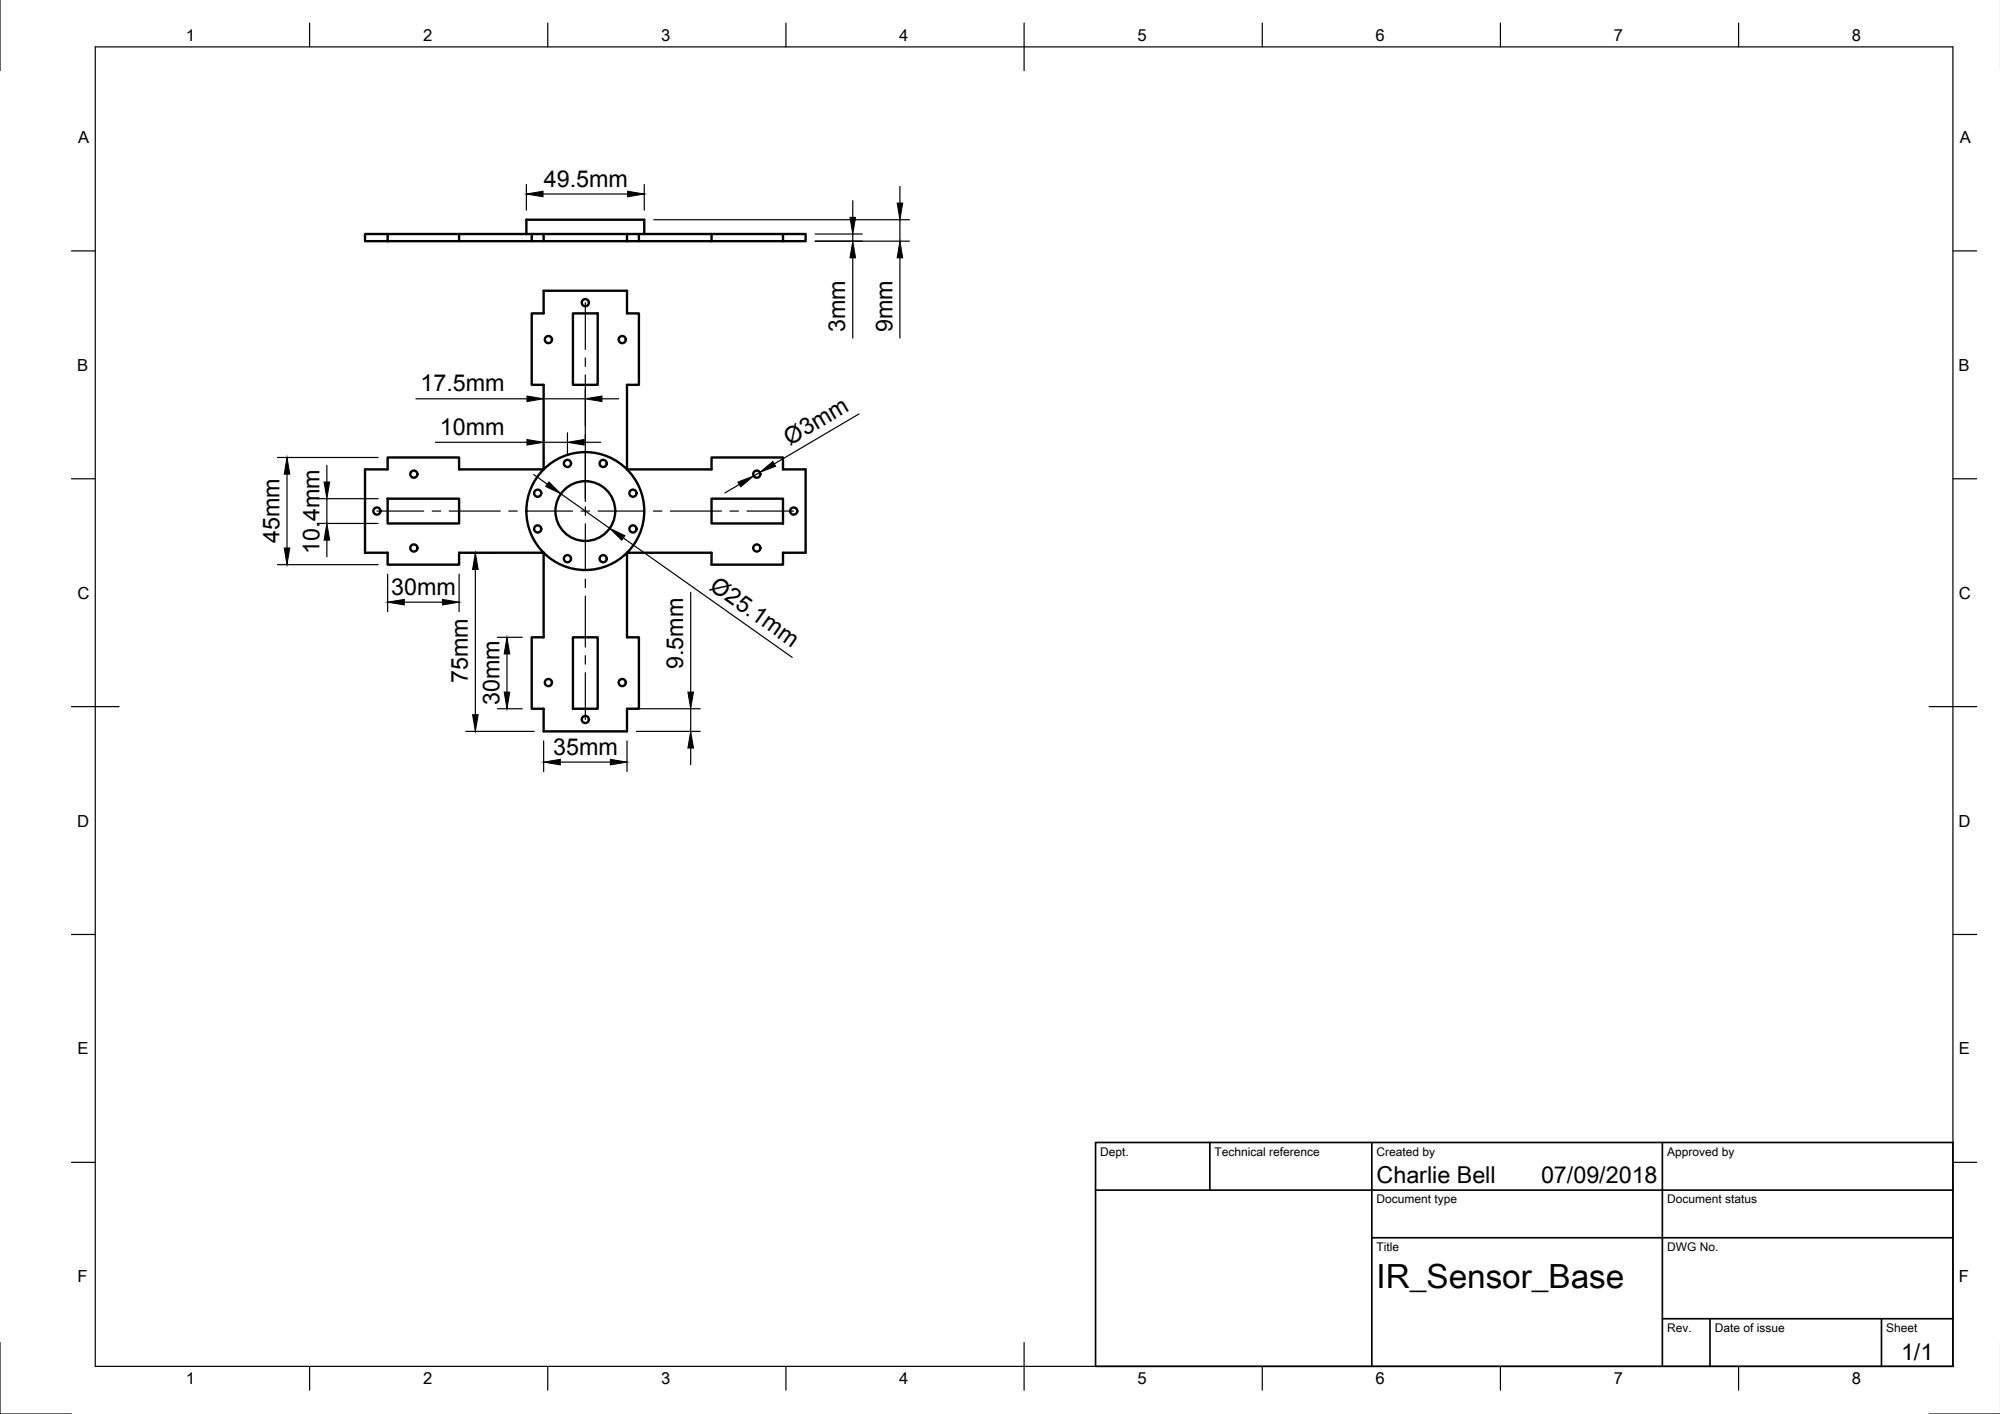
[picture p108: page 1]
Charlie Bell 3mm

Dept. | Technical reference | Created by 07/09/2018 | Approved by

Document type | Document status

Title IR_Sensor_Base | DWG No.

Rev. | Date of issue | Sheet 1/1
