ImperialCollegeLondon/QTIP/Images/Diagrams/motor_tips Drawing v4.pdf

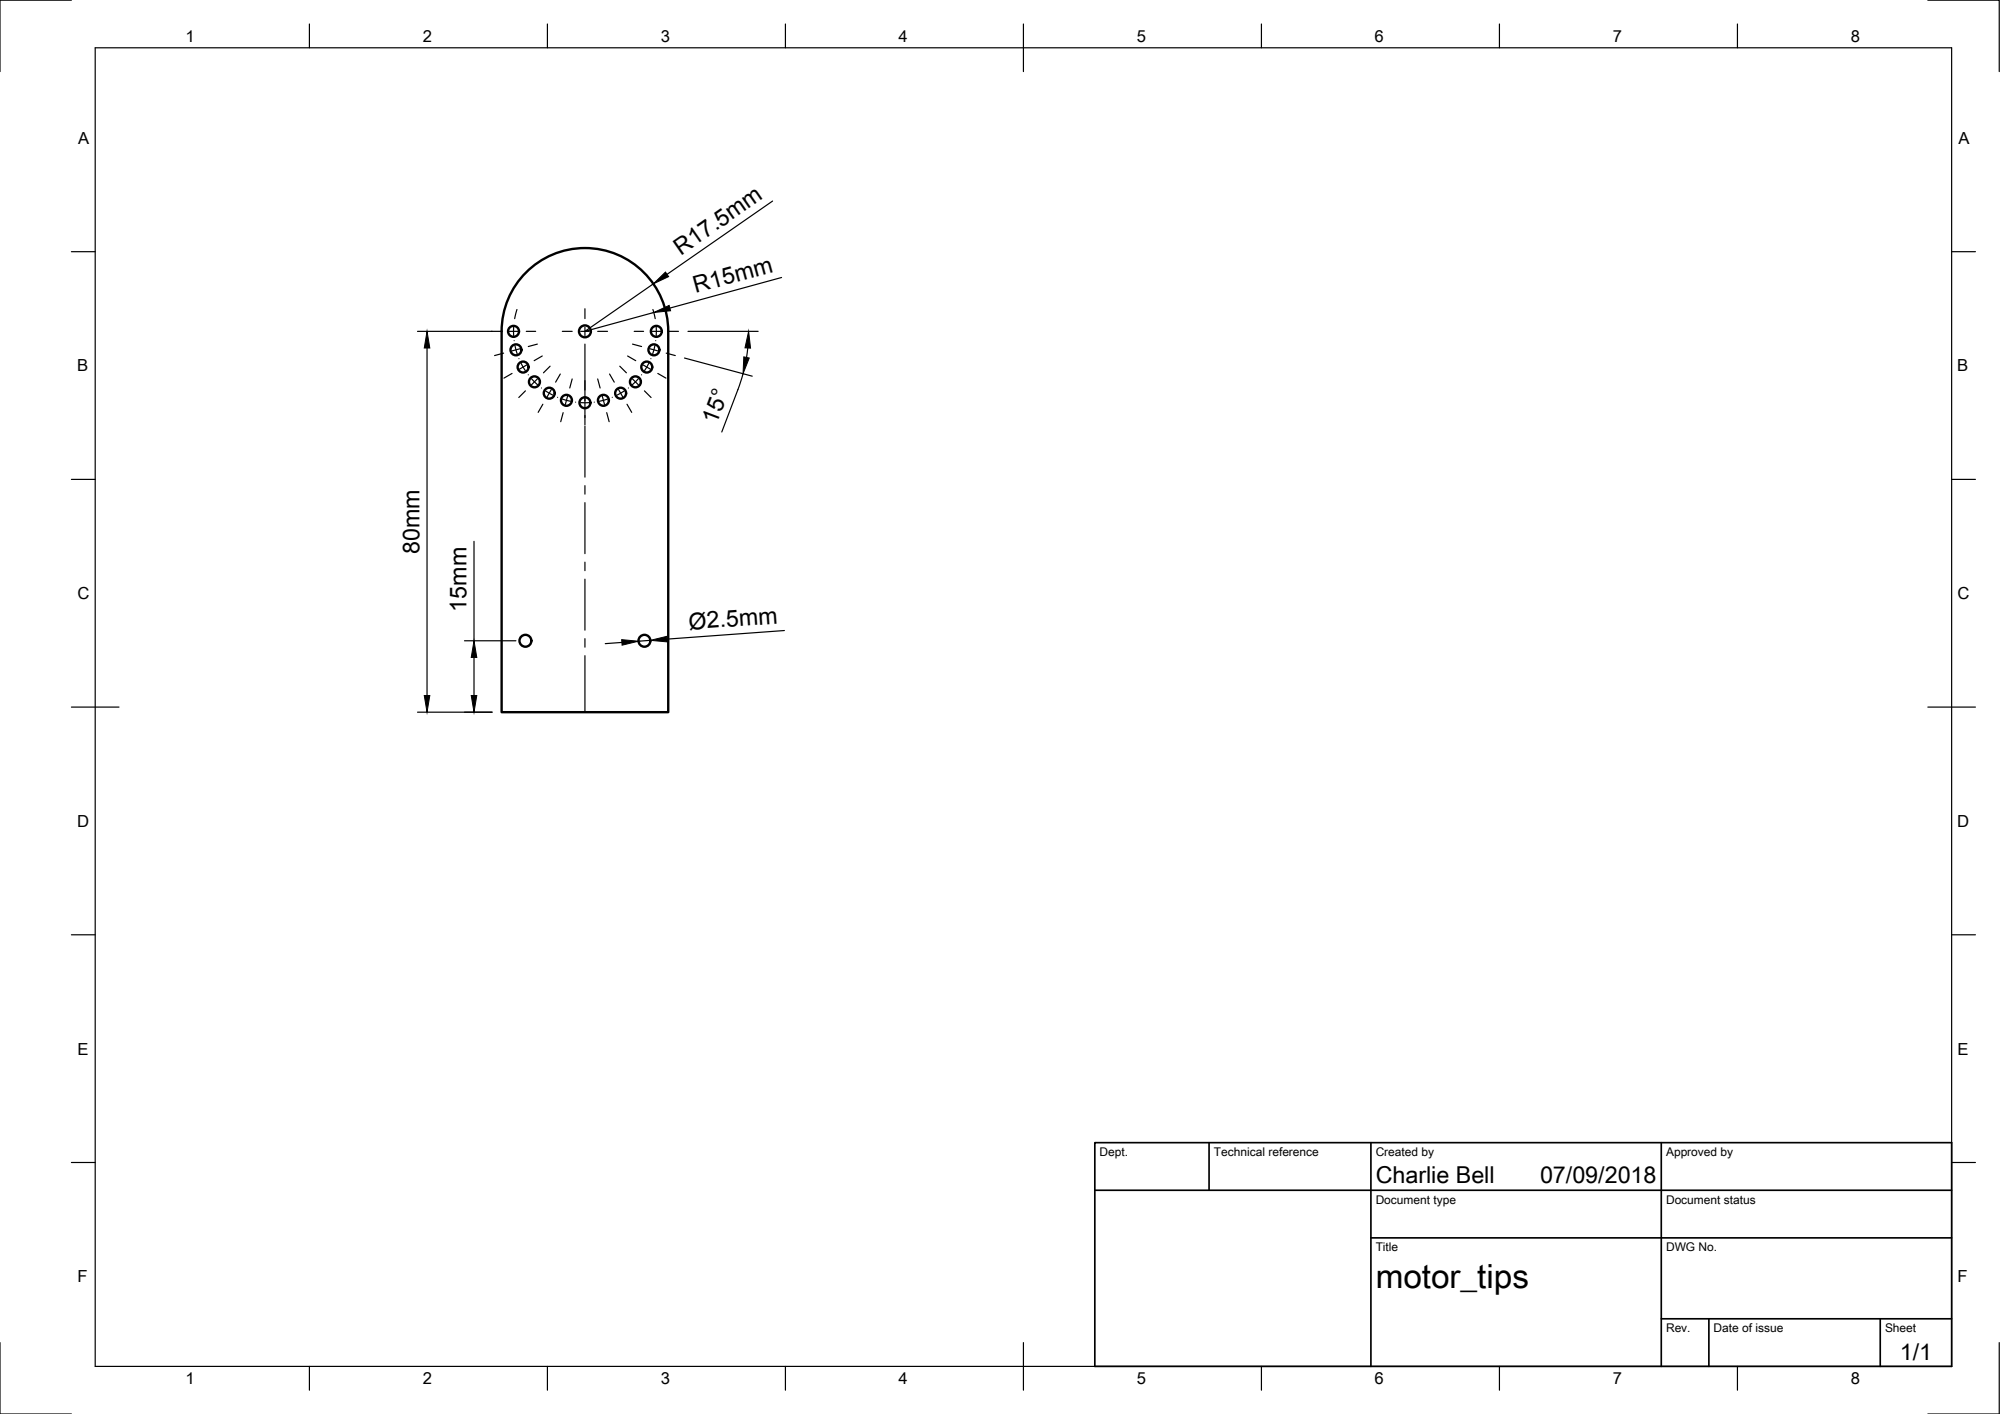
[picture p109: page 1]

Dept. | Technical reference | Created by Charlie Bell 07/09/2018 | Approved by

Document type | Document status

Title motor_tips | DWG No.

Rev. | Date of issue | Sheet 1/1
