ImperialCollegeLondon/QTIP/Images/Diagrams/MPU6050_base Drawing v4.pdf

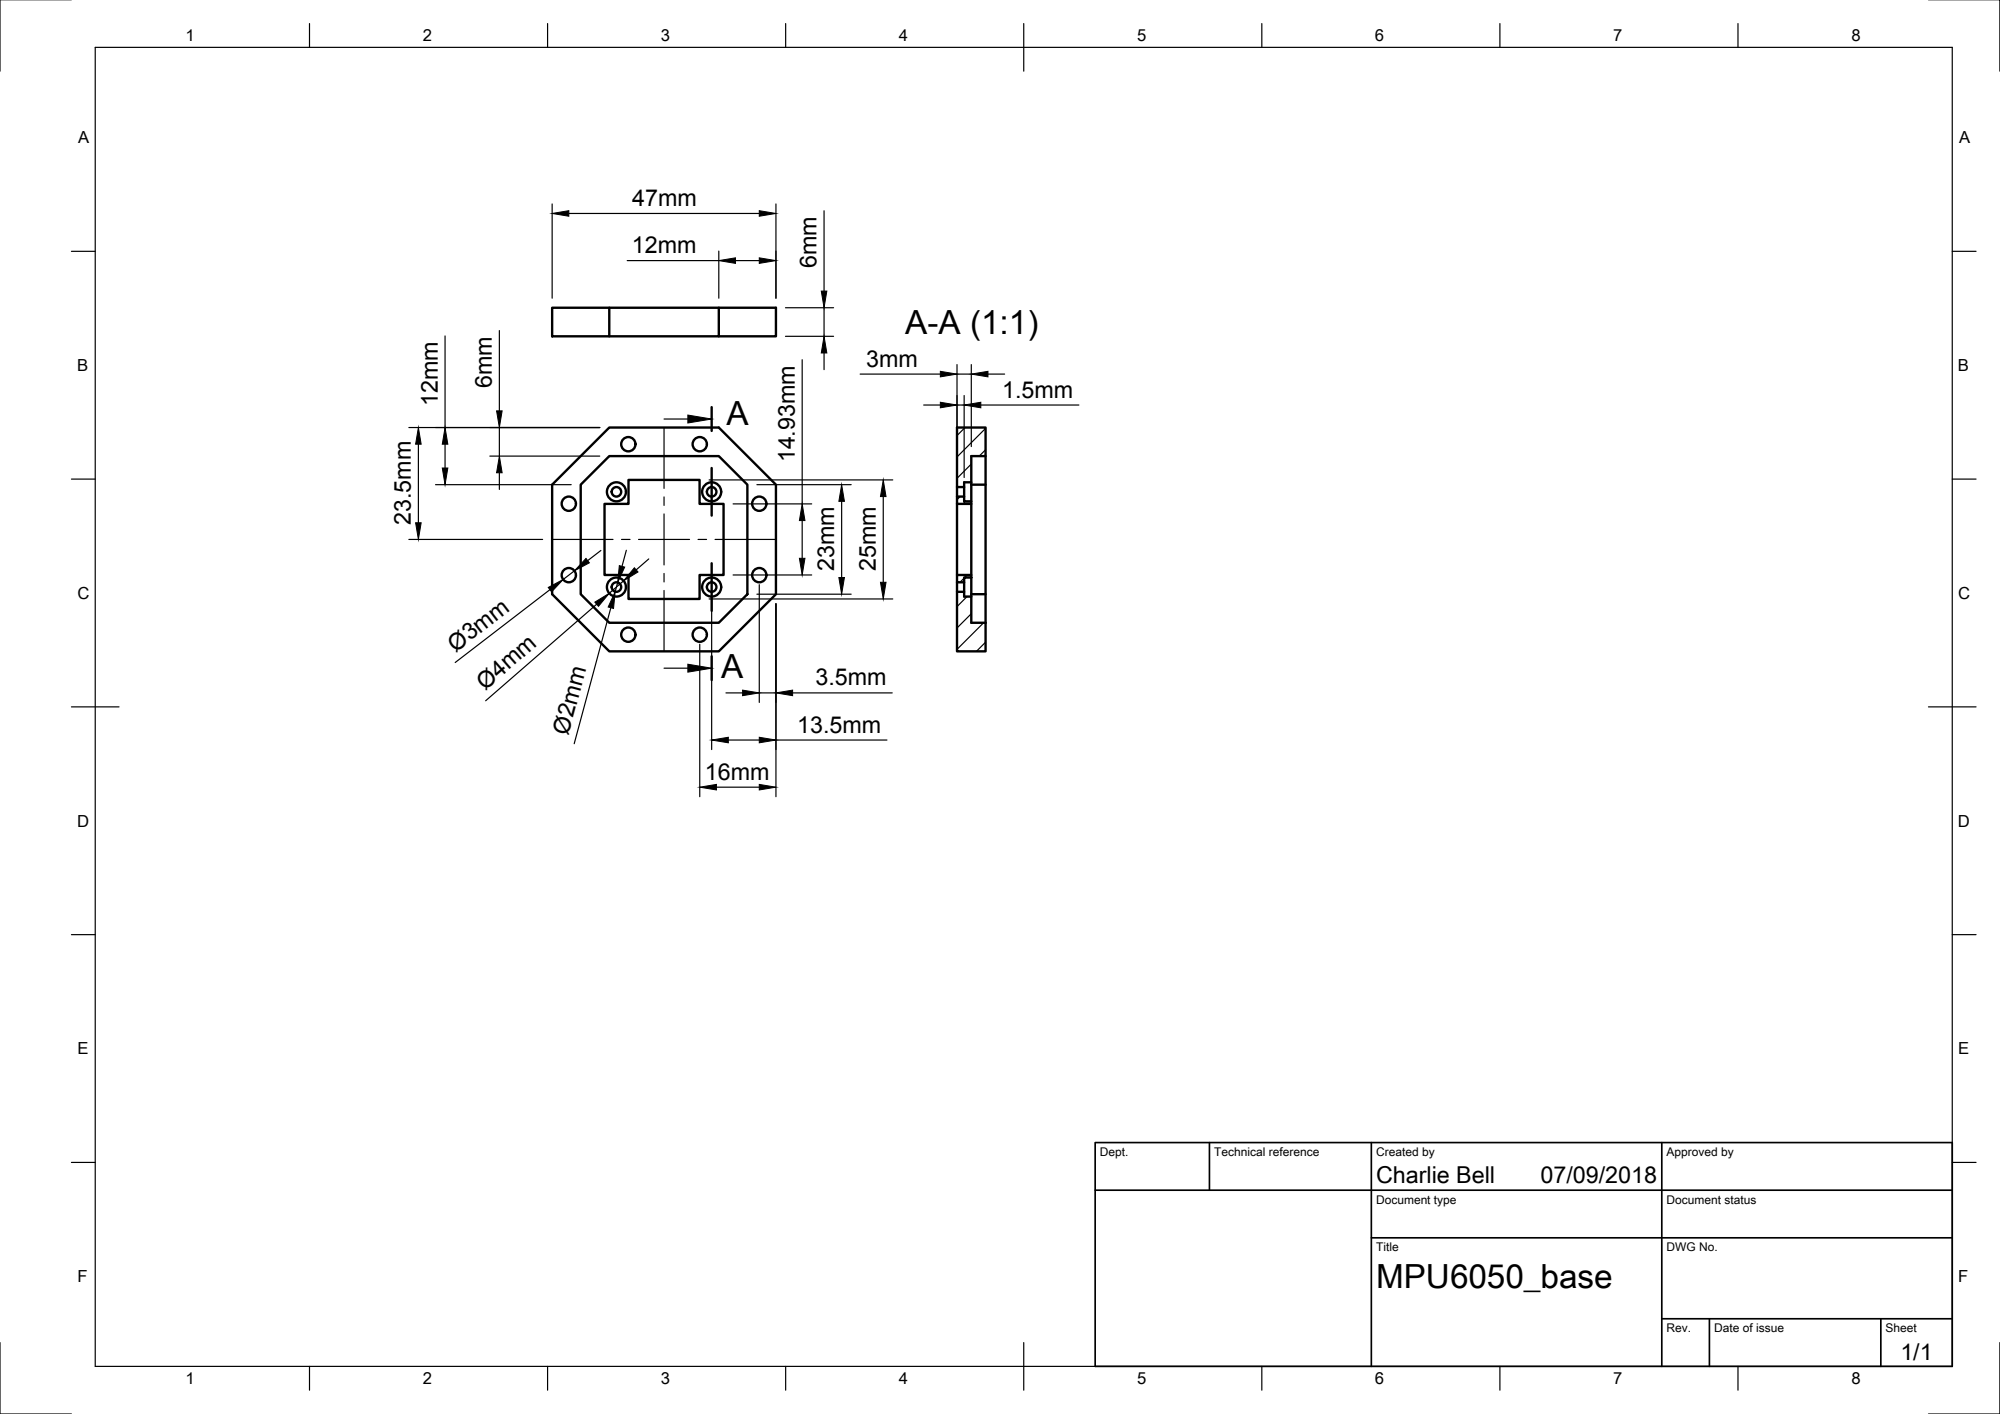
[picture p110: page 1]
Ø3mm Ø4mmØ2mm 23mm 25mm 14.93mm

Dept. | Technical reference | Created by Charlie Bell 07/09/2018 | Approved by

Document type | Document status

Title MPU6050_base | DWG No.

Rev. | Date of issue | Sheet 1/1
