ImperialCollegeLondon/QTIP/Images/Diagrams/platesensor Drawing v2.pdf

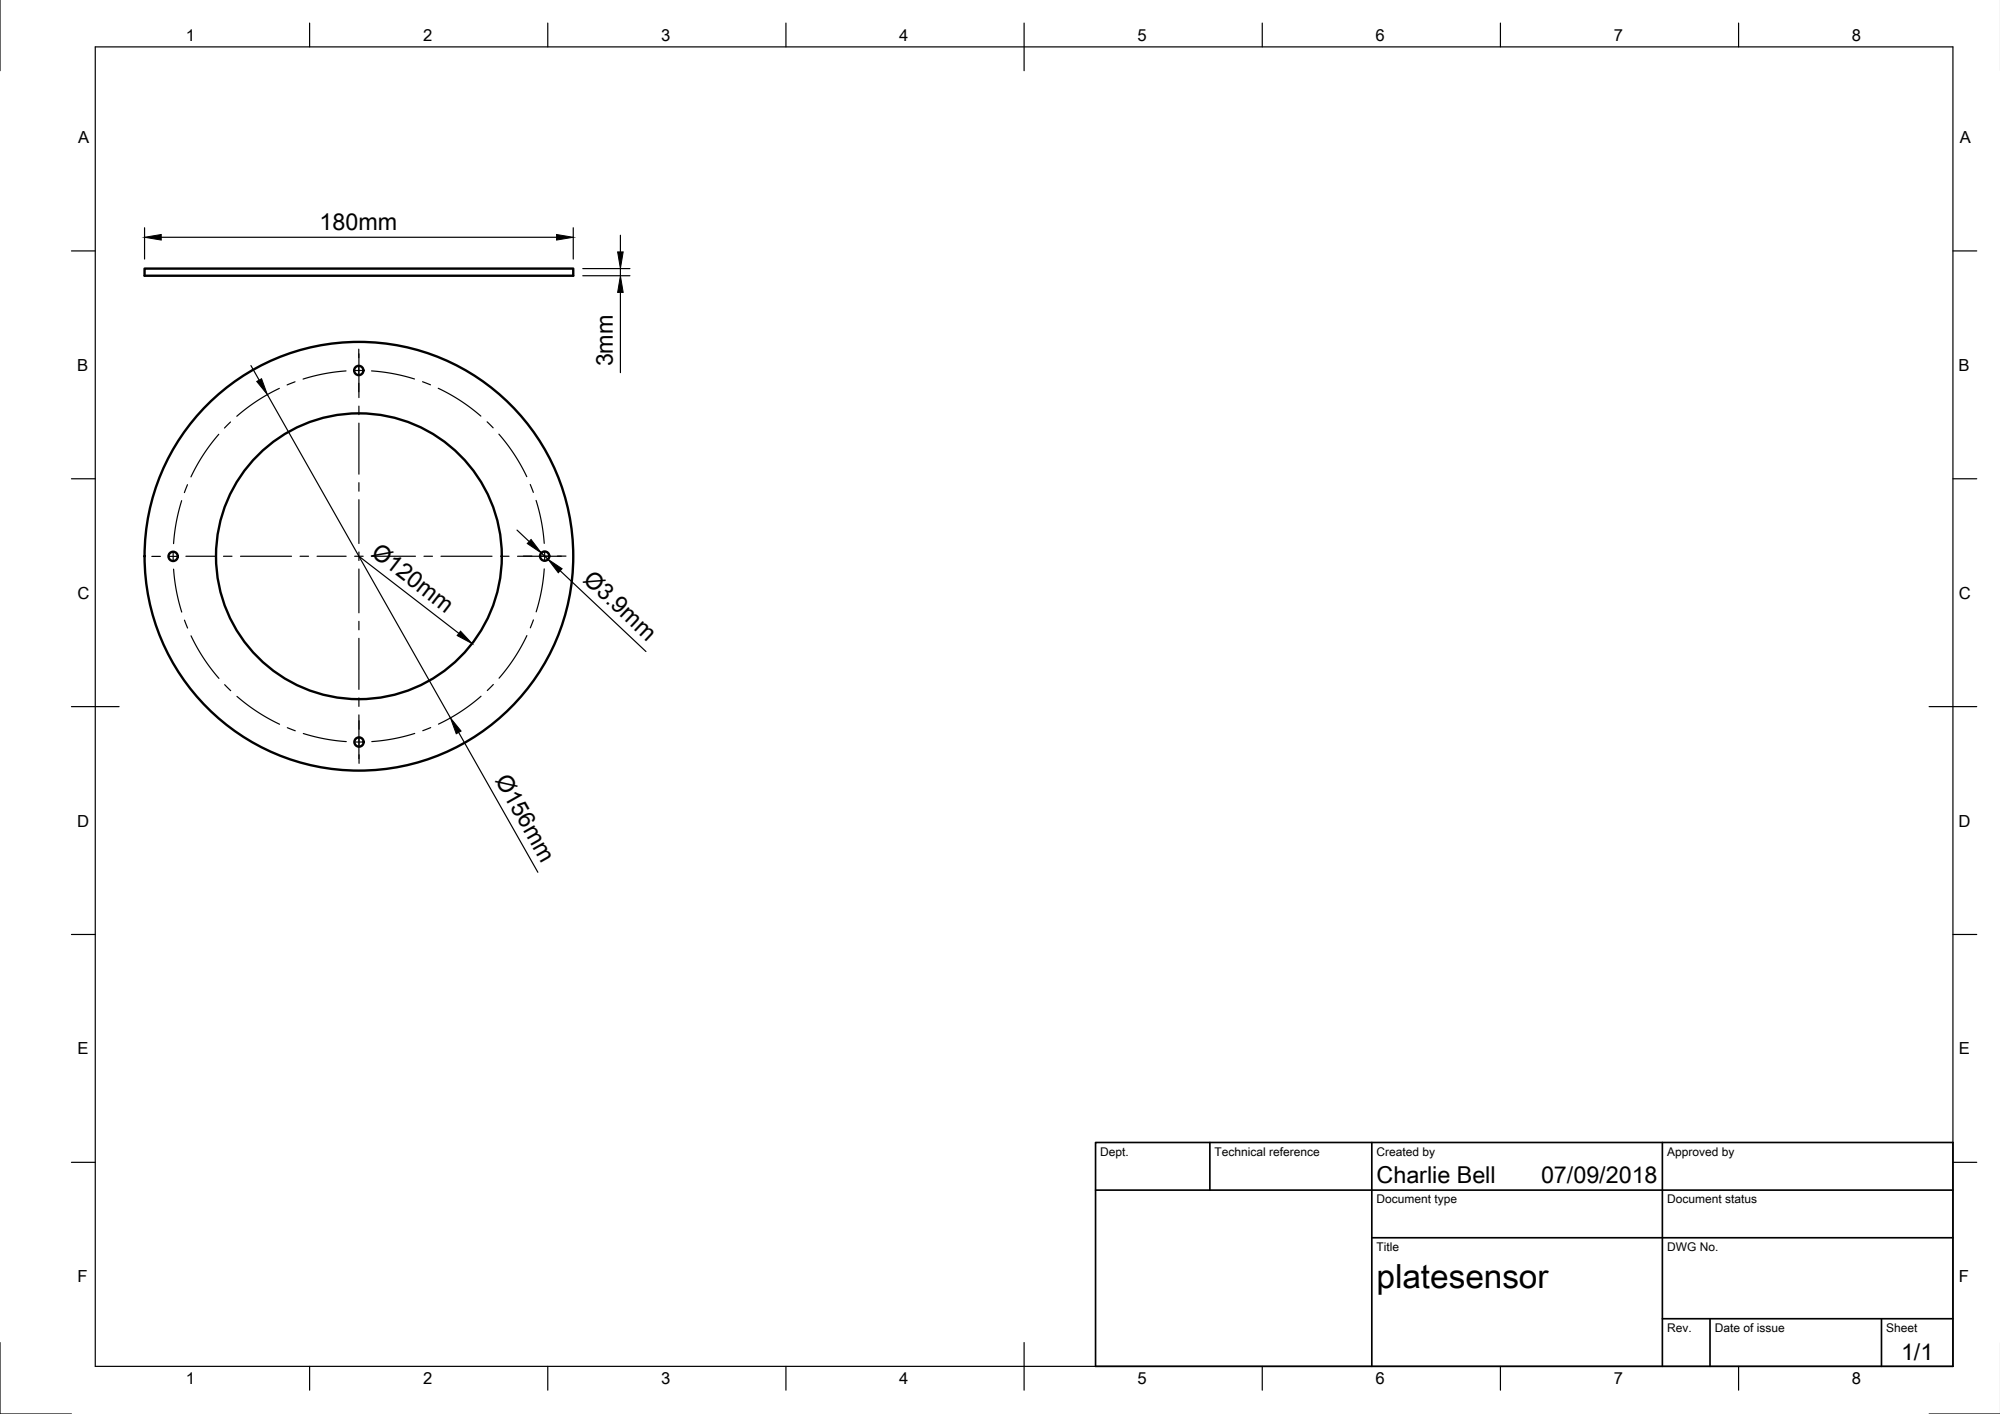
[picture p111: page 1]
Charlie Bell 3mm

Dept. | Technical reference | Created by 07/09/2018 | Approved by

Document type | Document status

Title platesensor | DWG No.

Rev. | Date of issue | Sheet 1/1
