ImperialCollegeLondon/QTIP/Images/Diagrams/distance sensing base Drawing v4.pdf

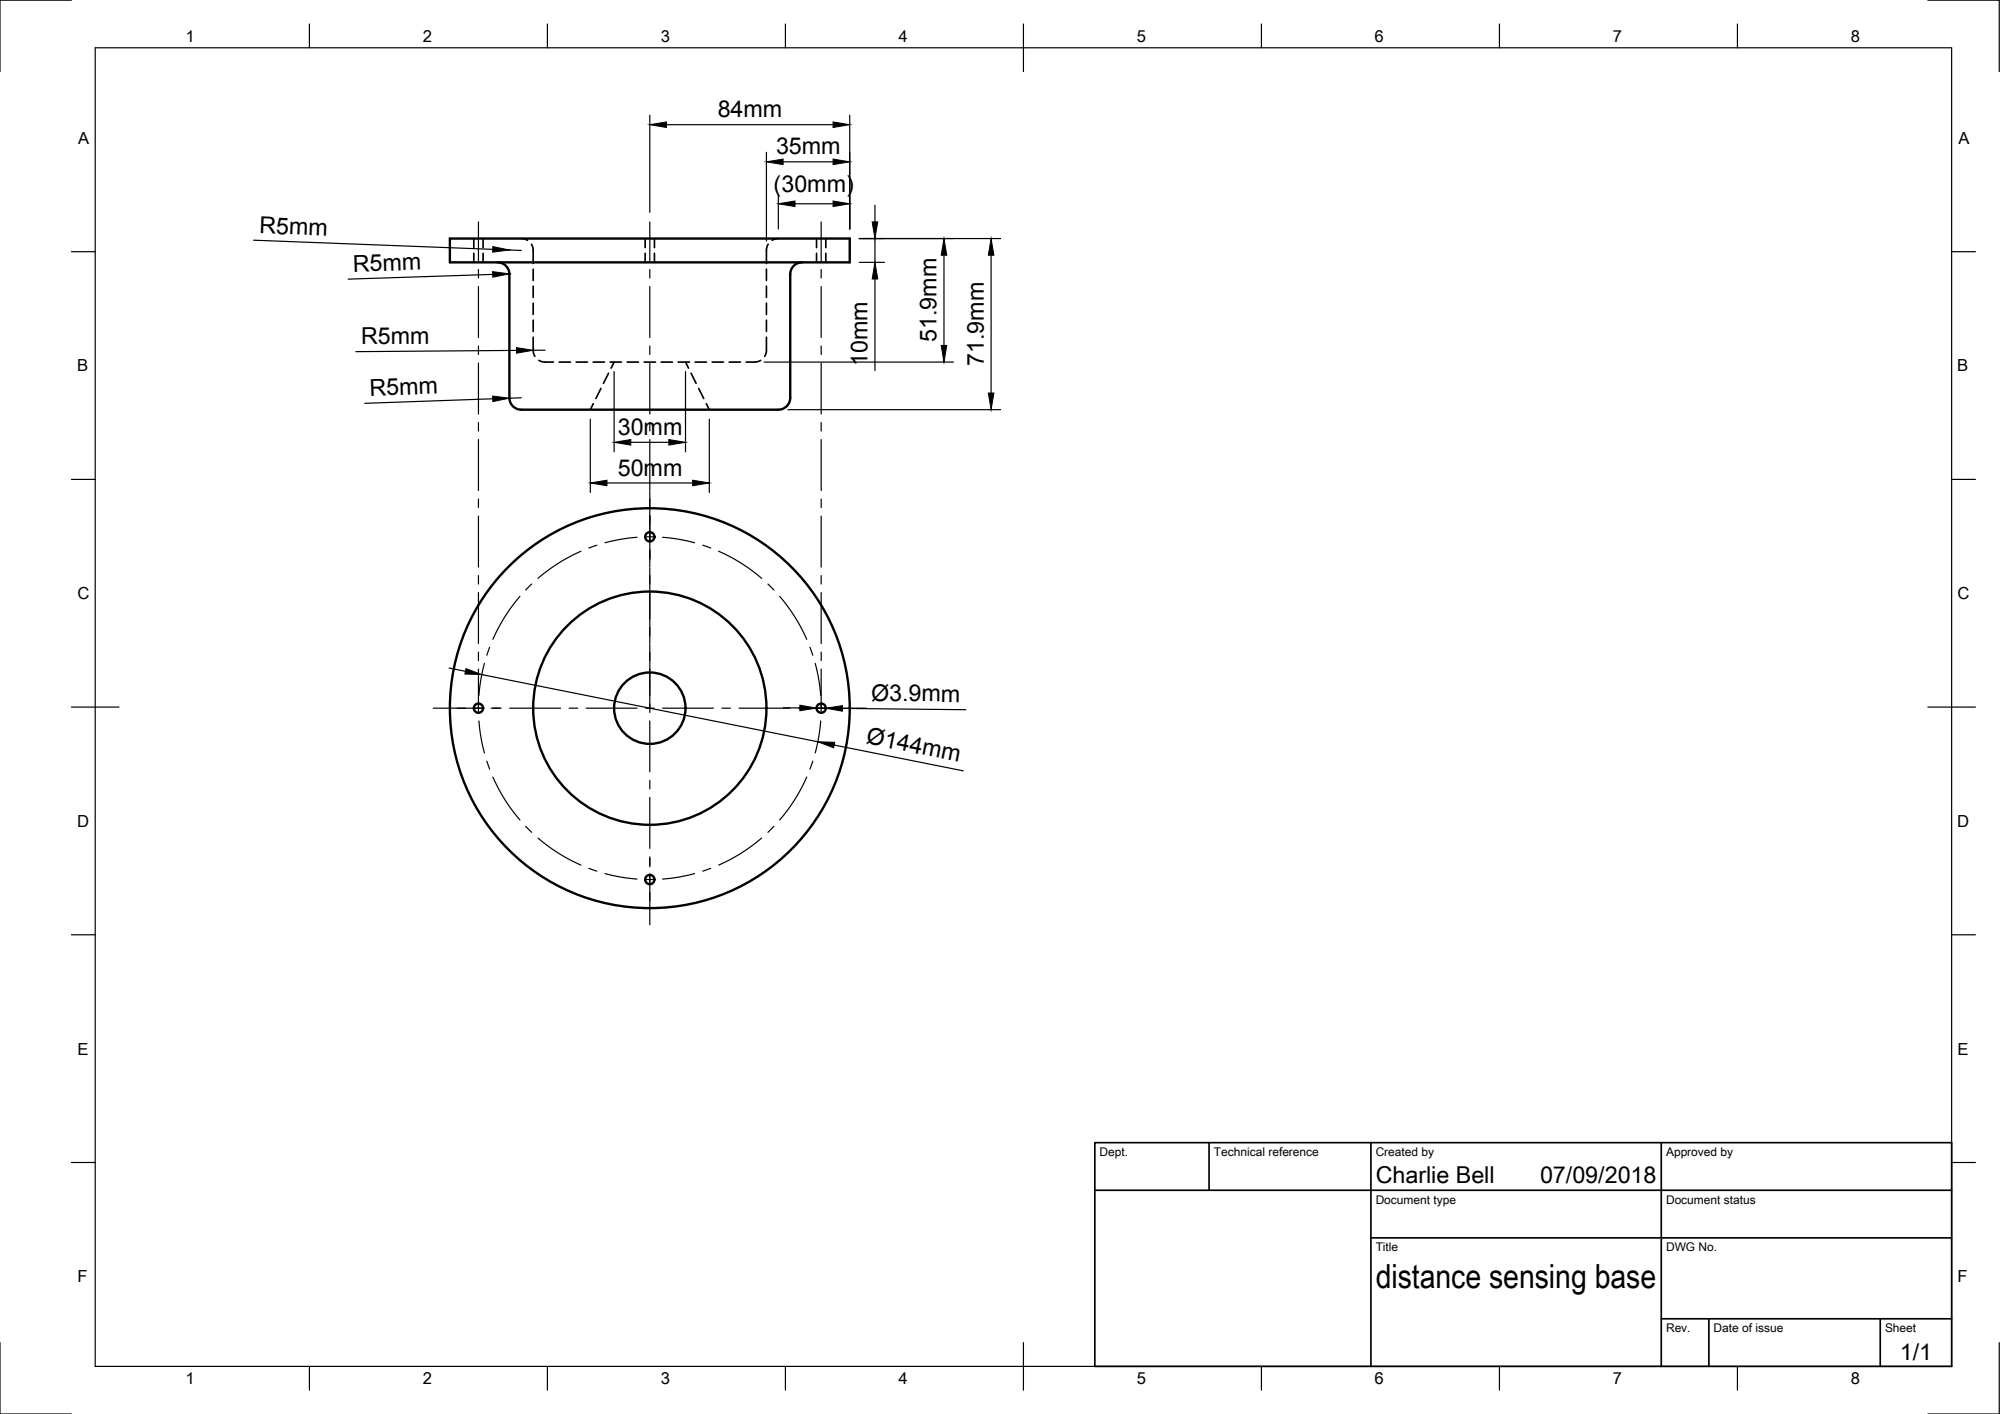
[picture p112: page 1]

Dept. | Technical reference | Created by Charlie Bell 07/09/2018 | Approved by

Document type | Document status

Title distance sensing base | DWG No.

Rev. | Date of issue | Sheet 1/1
