ImperialCollegeLondon/QTIP/Images/MCU mount/qtip_rev2.brd

## EAGLE design Images/MCU mount/qtip_rev2.brd (2019-04-29)

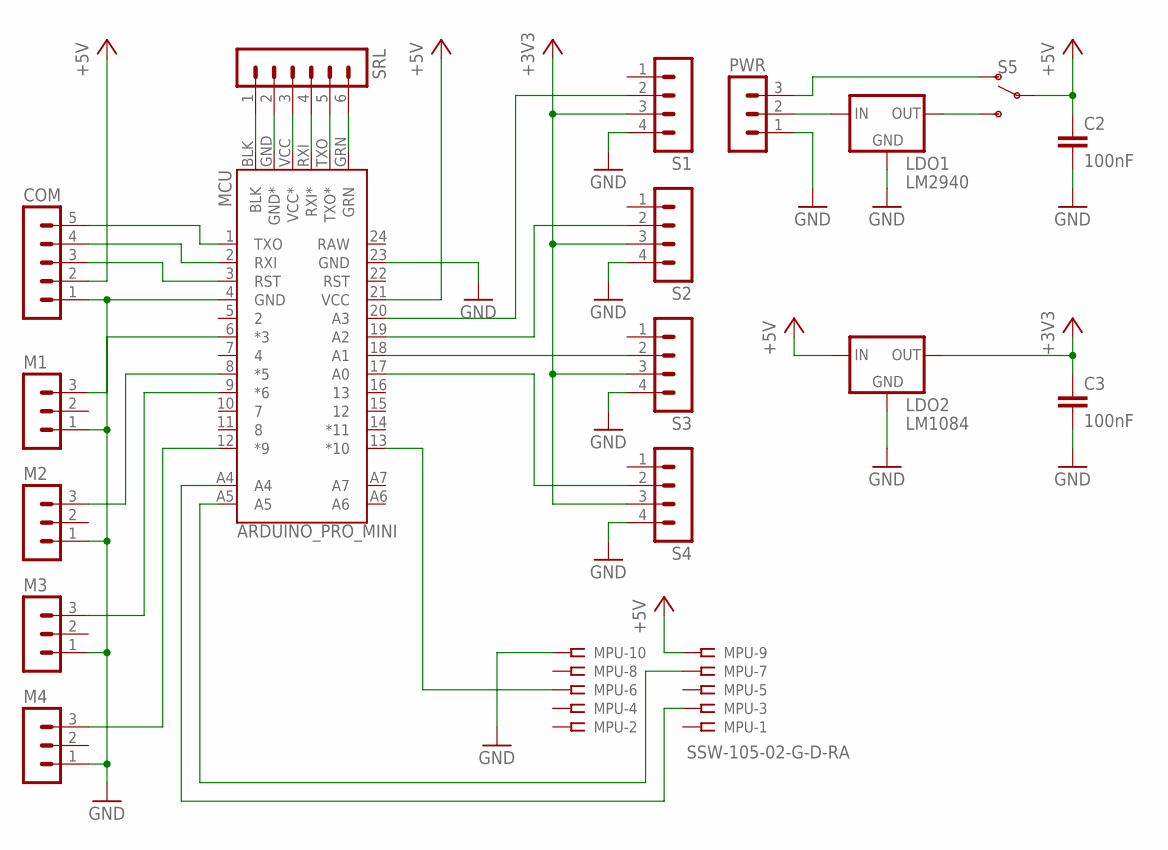
[picture p113: schematic qtip_rev2.sch]

Parts:
C2, C3: 100nF; C025-024X044
COM: MA05-1
LDO1: LM2940; 78XXL
LDO2: LM1084; 78XXL
M1, M2, M3, M4: MA03-1
MCU: ARDUINO_PRO_MINI
MPU: SSW-105-02-G-D-RA
PWR: MA03-1
S1, S2, S3, S4: MA04-1
S5: SWITCH-SPDT-PTH-11.6X4.0MM; SWITCH_SPDT_PTH_11.6X4.0MM
SRL: MA06-1

Connections:
+3V3: C3.1, LDO2.GND (OUT), S1.3, S2.3, S3.3, S4.3
+5V: C2.1, COM.2, LDO2.OUT (IN), MCU.21 (VCC), MPU.9, S5.2
GND: C2.2, C3.2, COM.1, LDO1.IN (GND), LDO2.IN (GND), M1.1, M2.1, M3.1, M4.1, MCU.4 (GND), MCU.23 (GND), MPU.10, PWR.1, S1.4, S2.4, S3.4, S4.4
MV2: M2.3, MCU.8 (*5)
unnamed: MCU.A5, MPU.7
unnamed: MCU.A4, MPU.3
unnamed: MCU.20 (A3), S1.2
unnamed: MCU.13 (*10), MPU.6
unnamed: MCU.17 (A0), S4.2
unnamed: M1.3, MCU.6 (*3)
unnamed: M4.3, MCU.12 (*9)
unnamed: M3.3, MCU.9 (*6)
unnamed: LDO1.OUT (IN), PWR.2
unnamed: MCU.BLK, SRL.1
unnamed: COM.5, MCU.1 (TXO)
unnamed: COM.4, MCU.2 (RXI)
unnamed: COM.3, MCU.3 (RST)
unnamed: MCU.GND (GND*), SRL.2
unnamed: MCU.18 (A1), S3.2
unnamed: MCU.VCC (VCC*), SRL.3
unnamed: MCU.19 (A2), S2.2
unnamed: MCU.RXI (RXI*), SRL.4
unnamed: LDO1.GND (OUT), S5.3 (S)
unnamed: MCU.TXO (TXO*), SRL.5
unnamed: PWR.3, S5.1 (O)
unnamed: MCU.GRN, SRL.6
RAW: MCU.24 (RAW)

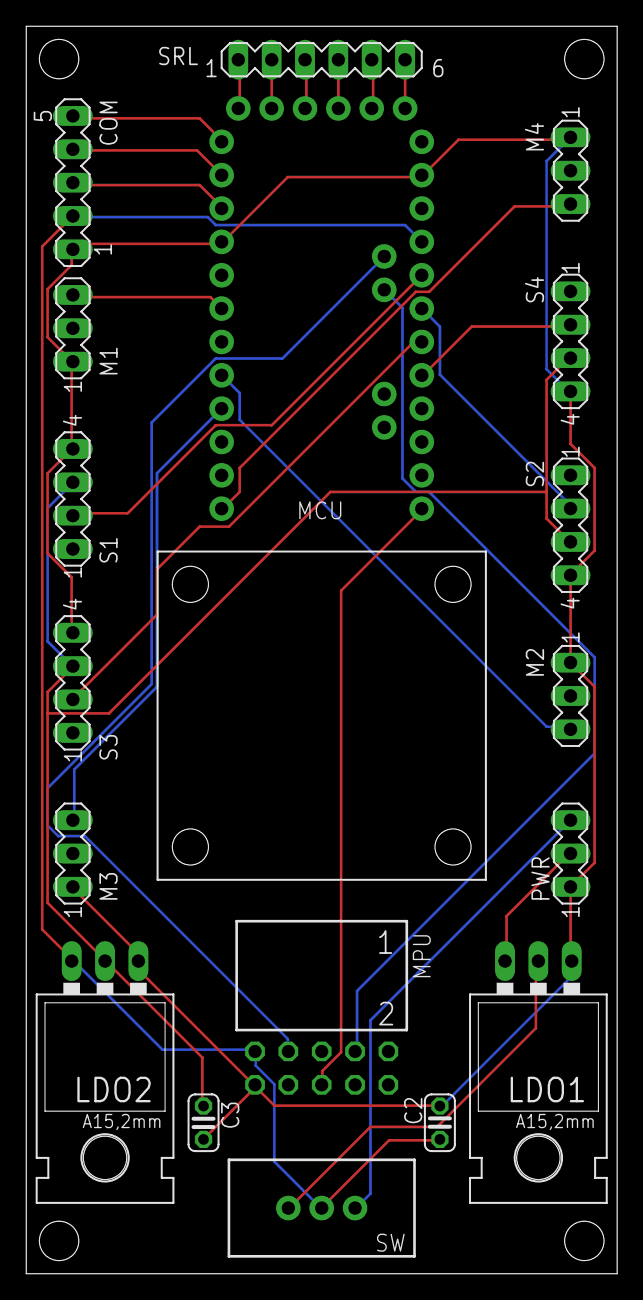
[picture p114: board qtip_rev2.brd from above]

Board: 2 copper layers, 45.0 x 95.0 mm, 18 parts (0 on the bottom side), 26 nets.
