ImperialCollegeLondon/QTIP/(commit log)

2018-06-27 Add files via upload
    I tried to have the files in different formats, but fusion failed all translations except for fusion files.
    [3dprintsensorholder (v1~recovered).f3d, Bot_Buggy v1.f3d, Mid_Buggy v1 v2.f3d, Top Motor Base (v1~recovered).f3d, Wheel v4.f3d, base_mount v7.f3d, base_pendulum v3.f3d, bot bug 3d v2.f3d]
2018-09-14 Arduino Code and Images upload
2018-09-26 All files upload
    Cleaned all files up
    [38e7b07e-975d-44f5-a386-fe88bf291c5e.f2d, 3dprintsensorholder (v1~recovered).f3d, 65a1e838-8545-4bc1-8616-6649744bad84.f2d, 86ccd2f9-dcbd-4ddc-8e51-228e1d89fba8.f2d, 90396298-6234-49ed-ab1d-8a921f07f61a.f2d, 9a99e573-6a53-4ff8-bab7-74f84905e94e.f2d, Bot_Buggy v1.f3d, CharlieBellResults.xlsx]
2019-04-26 MPU tester code optimised for Arduino Pro Mini 328
2019-04-26 PID Controller optimised for Arduino Pro Mini 328
2019-04-26 MCU and MPU mount board schematics upload
    compatible with Autodesk Eagle 9.x.x
    [qtip_s1.brd, qtip_s1.sch]
2019-04-26 Board and schematics images upload
2019-04-29 PCB design revision 2 + PCB design files upload
    [qtip_rev2.brd, qtip_rev2.sch]
2019-06-25 PID controller with serial comms
2019-06-25 MPU calibration sketch bug fix
    now it actually calibrates the DMP offsets
    [MPU6050_calibration.ino]
2019-07-01 Controller designer MATLAB scripts upload
    [motor duty cycle vs servo.xlsx]
2019-07-01 Test data used in project (PARK)
    [190517-01.csv, 190517-01.xlsx, 190517-02.csv, 190517-02.xlsx, 190517-03.csv, 190517-03.xlsx, 190517-04.csv, 190517-04.xlsx]
